Daavsan/Exjobb/Billder/Värmekamera/FLIR0883.jpg

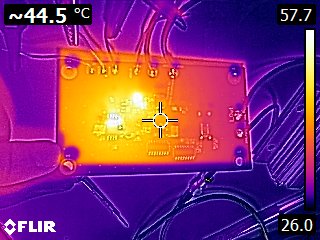
Billder/Värmekamera/FLIR0883.jpg
