Daavsan/Exjobb/Billder/Värmekamera/FLIR0885.jpg

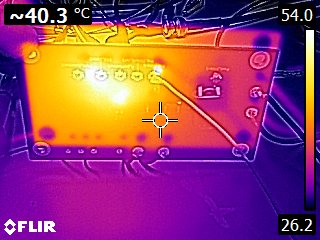
Billder/Värmekamera/FLIR0885.jpg
