Daavsan/Exjobb/Obsidian/Exjobb/Daglig rapport/Daglig rapport.md

# V38
## 24-09-17
Läst artiklar om berring currents, 20MHz, 20A. [1](https://blog.est-aegis.com/three-types-of-bearing-current) [2](file:///C:/Users/A1201-admin/Downloads/Circulating_bearing_currents_quantification-1.pdf) [3](https://www.est-aegis.com/bearing-protection/shaft-voltage-and-bearing-currents/)
Läst om förstärkare och strömgeneration. [Technology Overview](obsidian://open?vault=Exjobb&file=Ultra-High-Bandwidth_Power_Amplifiers_A_Technology_Overview_and_Future_Prospects.pdf)  ej läst denna än [bang bang ](https://ieeexplore.ieee.org/document/1297944)

Möte med jonny och johan.
* Mål är relativt flytande, jag har stor kontrol
* FPGA kan ge olika out, ex pwm eller digital bitar
* 20A vid extremfall <0.5 $\Omega$  -> 100w max i pulser
* 1-5w continuerligt
* bang buck
* åtminståne skri om digtal DA alternativ
* pressision tpy 5% men viktigare att möta med hög pressition

## 24-09-17
asd
