Daavsan/Exjobb/Obsidian/Exjobb/High pressision mesurments.md

[Sensor Overview](https://ieeexplore.ieee.org/abstract/document/1257710) 
* Shunts: 
	* cheap  
	* DC and AC
	* [equations](https://incompliancemag.com/difference-amplifier-common-mode-and-differential-mode-voltages/) 
* Current transformer
	* Capable of tens of MHz
	* Driving circuit are normally not
	* up to 5KA, wiht 20 ns rise time
	*
