Daavsan/Exjobb/Obsidian/Exjobb/PWM Generation.md

[inverter based PWM](https://www.robotroom.com/PWM.html)

Can generate pwm with diode caoacitora nd varableresistor, where r determens the duty cycle

555 Timmer commonly used, but >[[Amplifers#^3f6317||60-200MHz]] is to high (555 max is a few hundred KHz)

Three stage opamp and comparator [PWM generator](https://www.ti.com/lit/an/sboa212a/sboa212a.pdf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) design

Simple [resistor-diode-capacitor-inveter](https://www.robotroom.com/PWM.html) design, obs i couldn't simulate

![[Pasted image 20240923124735.png]]

This [paper](https://ieeexplore.ieee.org/abstract/document/4562735) for fast current mode tirangular wae generator
