Daavsan/Exjobb/Obsidian/Exjobb/Berring Currents.md

* Frequency [up to 20MHz](https://webfiles.portal.chalmers.se/et/MSc/Marinov&RahmanMSc.pdf)
* larger power motor-> higher frequency. 
* Energy has to reach threshold to make arc.
* [up to 20 ampere](https://blog.est-aegis.com/three-types-of-bearing-current) 
* [maybe 0.5 ohm at max](Johan borg) -> ca 100 w peak output power
