Daavsan/Exjobb/Obsidian/Exjobb/Circuit PID.md

[Analog PID](https://link.springer.com/article/10.1007/s00034-020-01540-5) Consept for pull pid

Alt parralell P I D
P: Just gain idk
I: [integrator](https://en.wikipedia.org/wiki/Op_amp_integrator) 
D: [Diffrentiator](https://en.wikipedia.org/wiki/Differentiator)

[Selfe tune analaog pid](https://ieeexplore.ieee.org/abstract/document/1638134)

[PID IN buck boost](https://link.springer.com/article/10.1186/s43067-020-00015-6)

PID in loop to control current

####  Pros
* can control overshoot/Undershoot
* System (except load) Well know -> can tune
* Analog and digital implementation possible.
* I get to apply some control theory
#### Cons
* Reactive load may make tuning hard
* More complex system 

[Self tuning pid](https://ieeexplore.ieee.org/abstract/document/1638134) obs needs microcontroller
[Pid Design](https://www.mdpi.com/1424-8220/24/10/3125)
[pid design, easy to choose poles](https://ieeexplore.ieee.org/abstract/document/9331798)
[Hih input low output inpedance, 3 passive to tune](https://link.springer.com/article/10.1007/s00034-020-01540-5) Kp has min value :[
