Daavsan/Exjobb/Obsidian/Exjobb/Current generator deign.md

## Amplifiers
In this paper[Technology overview](https://ieeexplore.ieee.org/stamp/stamp.jsp?tp=&arnumber=9766331) 

Ide, buck converter, där pwm duty cule styrs av en controller. Alltså FPGA ger (börsingnal-feedback) --> styr cycle på buck. Efter low pass filter mäts ström = feedback 

In [[Ultra-High-Bandwidth_Power_Amplifiers_A_Technology_Overview_and_Future_Prospects.pdf#page=7&selection=0,9,35,34|Ultra-High-Bandwidth_Power_Amplifiers_A_Technology_Overview_and_Future_Prospects, page 7]]
Hyprid (digital and analog) is combined ex, in parralell, with a main supply and a "fine tuning" supply

## Read plan

* [[Berring Currents]] Done
* [[Amplifers]]- ongoing
* [[Circuit PID]]- ongoing
* [[ADC and DAC]] -NOT STARTED
* [[PWM Generation]] -Ongoing
* [[High pressision mesurments]]- NOT started

### Switch test 1
[[Components]]

switching mosfet  and gatedriver test [[switching mosfet  and gatedriver test]]  asd
