Daavsan/Exjobb/Obsidian/Exjobb/Links.md

# Gate driver
[LMG1020-5v 7A 50Mhz](https://www.ti.com/lit/ds/symlink/lmg1020.pdf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)
[LMG1210-200v 3A 50Mhz](https://www.ti.com/lit/ds/symlink/lmg1210.pdf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)
[LMG1025-Q1 60Mhz](https://www.ti.com/lit/ds/symlink/lmg1025-q1.pdf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)

# Mosfets

### RF
[AFT05NP075NR1 136-520 Mhz](https://www.mouser.se/ProductDetail/NXP-Semiconductors/AFT05MP075NR1?qs=RnZx02BLotIGApUaCX%252B4pw%3D%3D) 
[MRF101AN 110W 8A](https://www.mouser.se/datasheet/2/302/MRF101AN-1510799.pdf)

### Non-RF

[mouser](https://www.mouser.se/c/semiconductors/discrete-semiconductors/transistors/rf-transistors/rf-mosfet-transistors/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)
[CSD19538q2](https://www.ti.com/lit/ds/symlink/csd19538q2.pdf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)
[CSD17579Q3A](https://www.ti.com/lit/ds/symlink/csd17579q3a.pdf?ts=1727669525473)

#### Boot strap diode
[100p trr, 70V BAS7002VH6327XTSA1](https://www.digikey.se/en/products/detail/infineon-technologies/BAS7002VH6327XTSA1/5959843)
