Daavsan/Exjobb/Obsidian/Exjobb/Mosfet.md

[Power mosfets gate charge](https://www.vishay.com/docs/73217/an608a.pdf)
