Daavsan/Exjobb/Billder/BearingCurrents.png

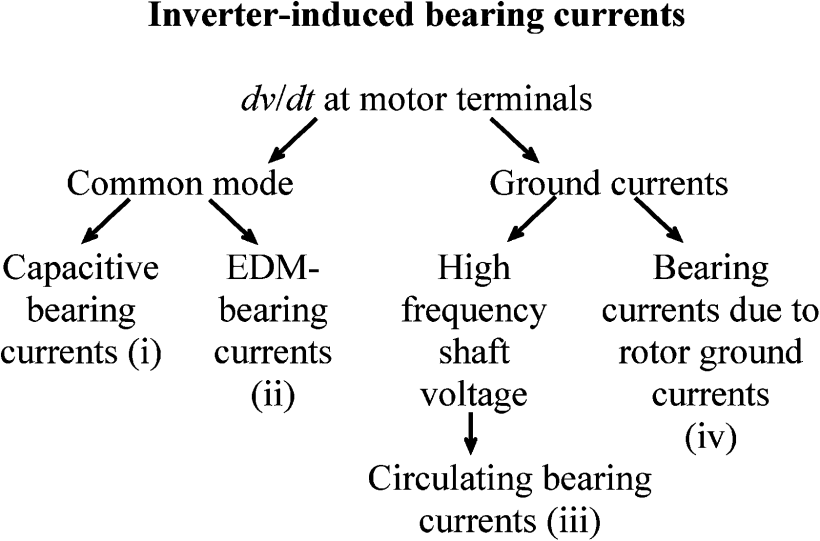
Billder/BearingCurrents.png
