Daavsan/Exjobb/Billder/Prot2/Controller.png

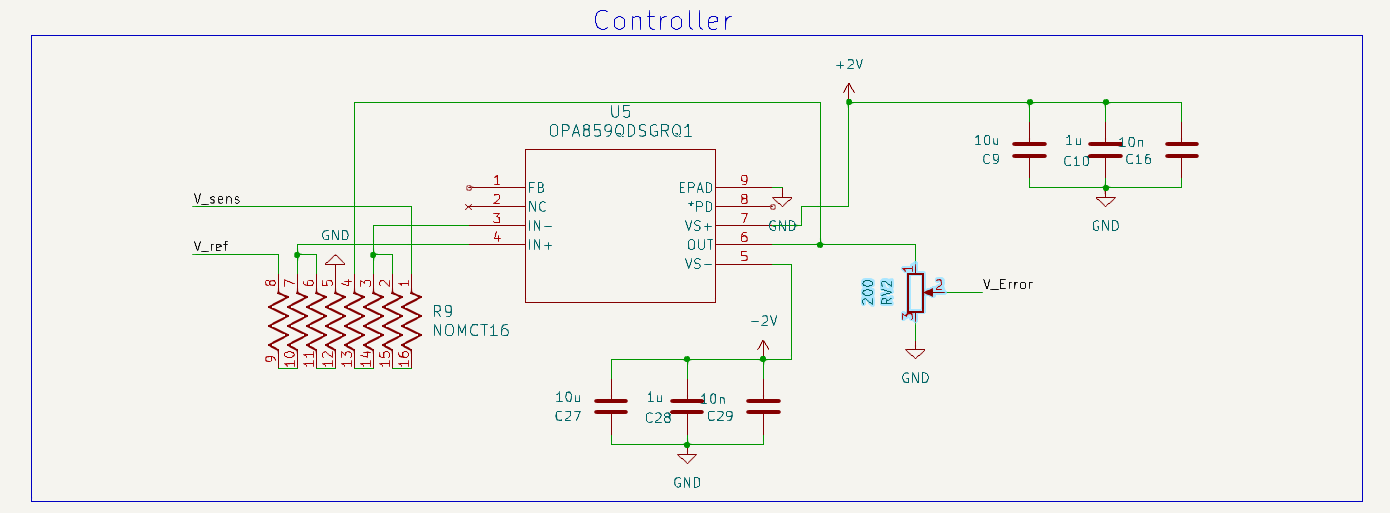
Billder/Prot2/Controller.png
