Daavsan/Exjobb/Billder/Prot2/Filter And Sensor.png

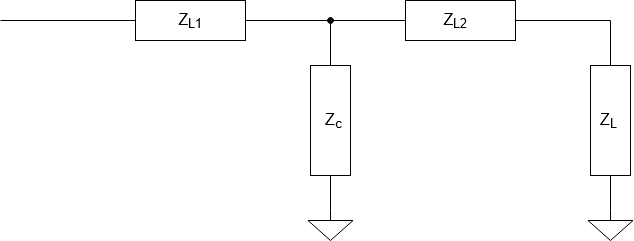
Billder/Prot2/Filter And Sensor.png
