Daavsan/Exjobb/Billder/Prot2/Filter.png

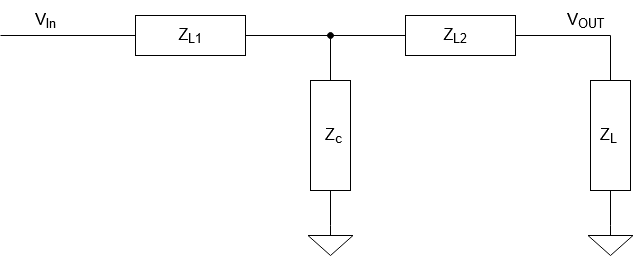
Billder/Prot2/Filter.png
