Daavsan/Exjobb/Billder/Prot2/Layout.png

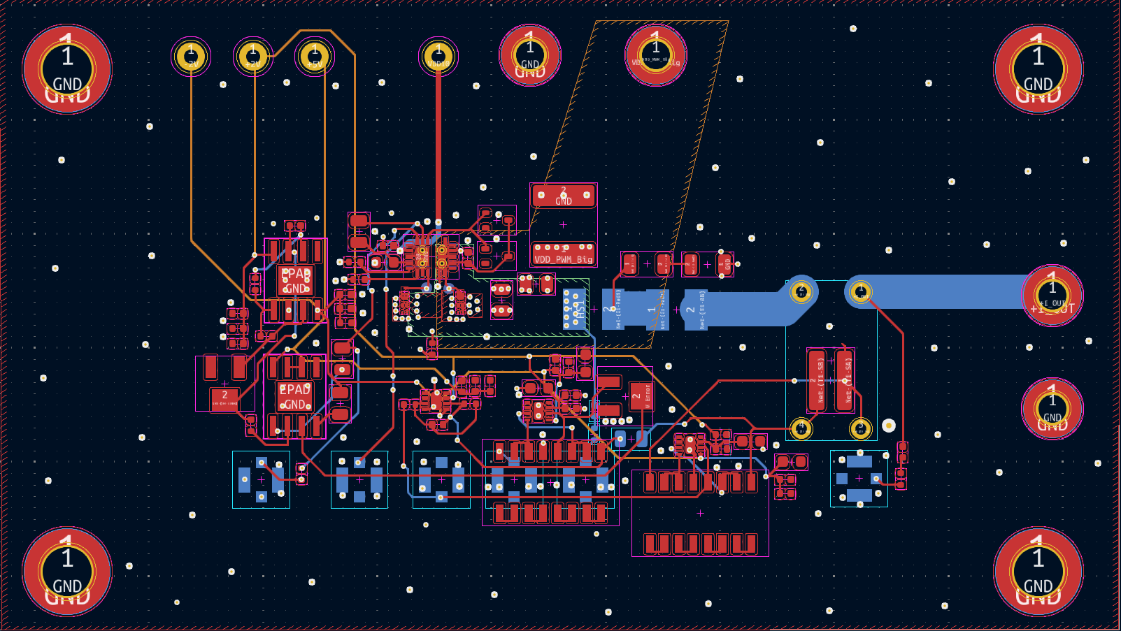
Billder/Prot2/Layout.png
