Daavsan/Exjobb/Billder/Prot2/PWM Generator.png

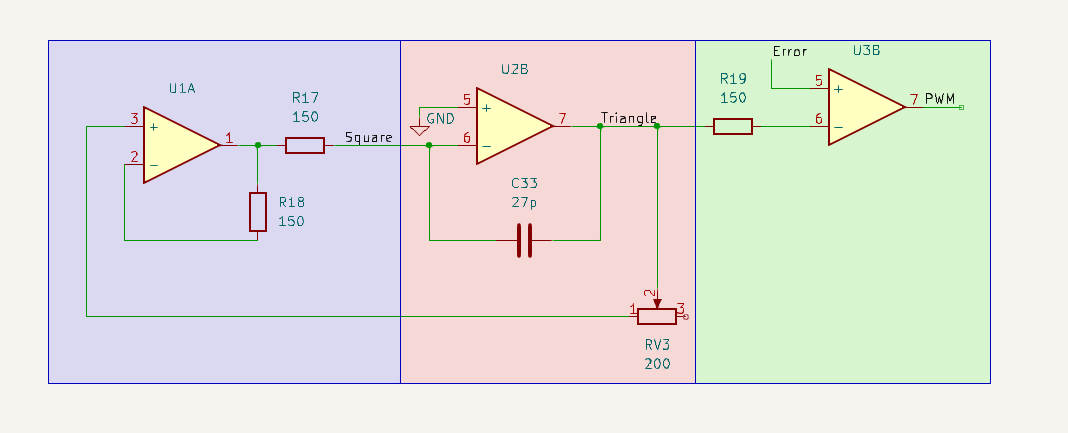
Billder/Prot2/PWM Generator.png
