Daavsan/Exjobb/Billder/Prot2/PWM Generatpr Circut.png

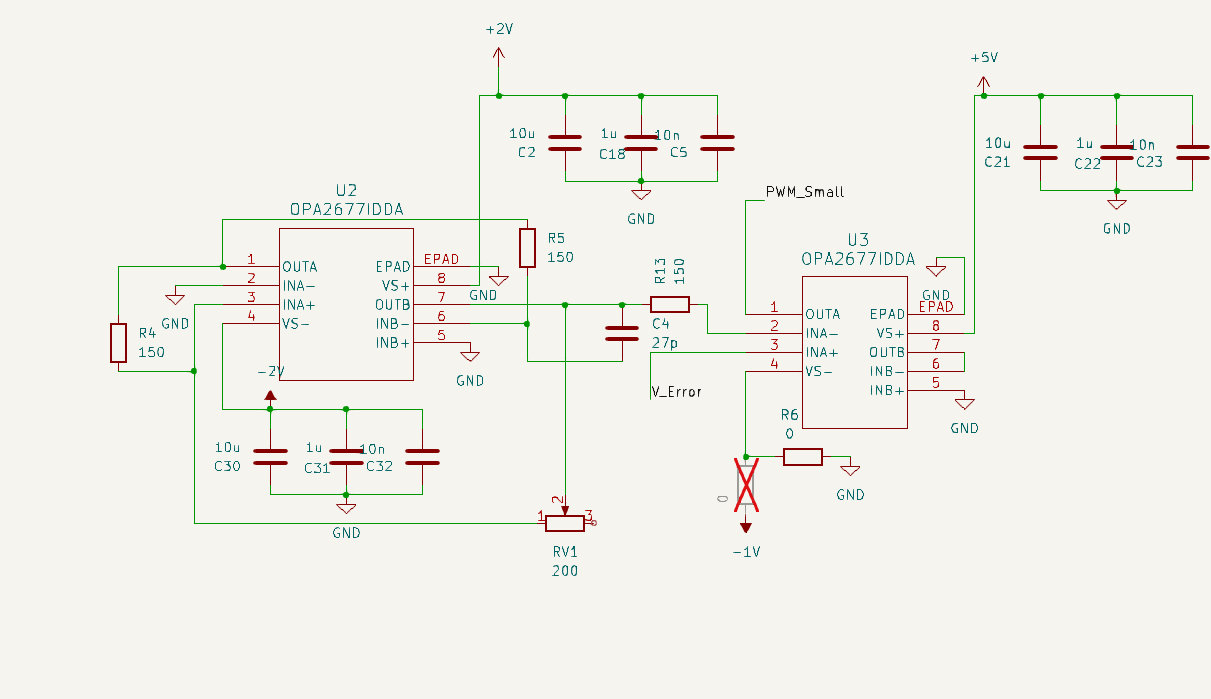
Billder/Prot2/PWM Generatpr Circut.png
