Daavsan/Exjobb/Billder/Prototype1/GateDriverOutput.png

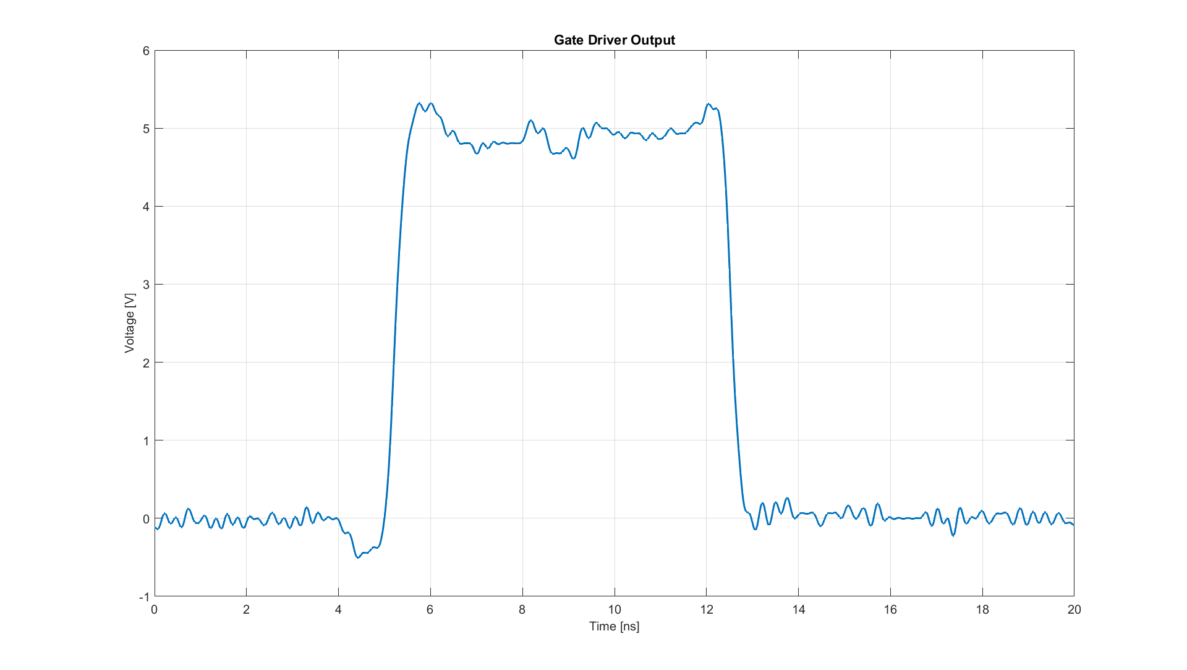
Billder/Prototype1/GateDriverOutput.png
