Daavsan/Exjobb/Billder/Värmekamera/FLIR0881.jpg

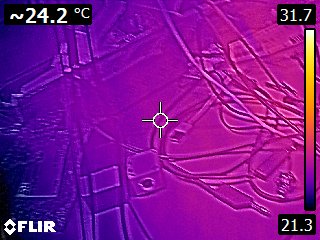
Billder/Värmekamera/FLIR0881.jpg
