Daavsan/Exjobb/Billder/Värmekamera/FLIR0882.jpg

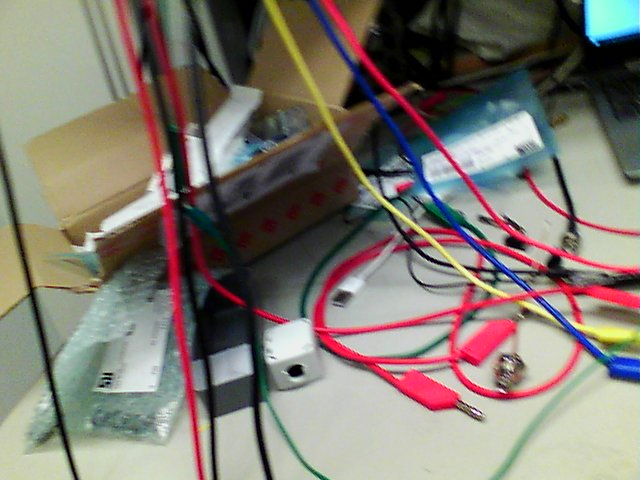
Billder/Värmekamera/FLIR0882.jpg
