Daavsan/Exjobb/Billder/Värmekamera/FLIR0884.jpg

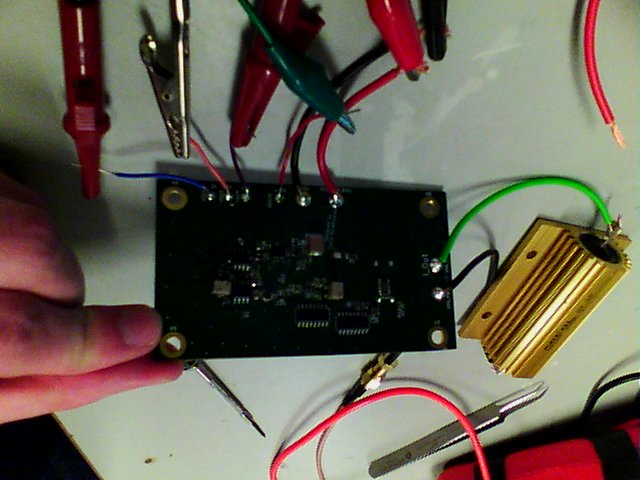
Billder/Värmekamera/FLIR0884.jpg
