Daavsan/Exjobb/Billder/Värmekamera/FLIR0886.jpg

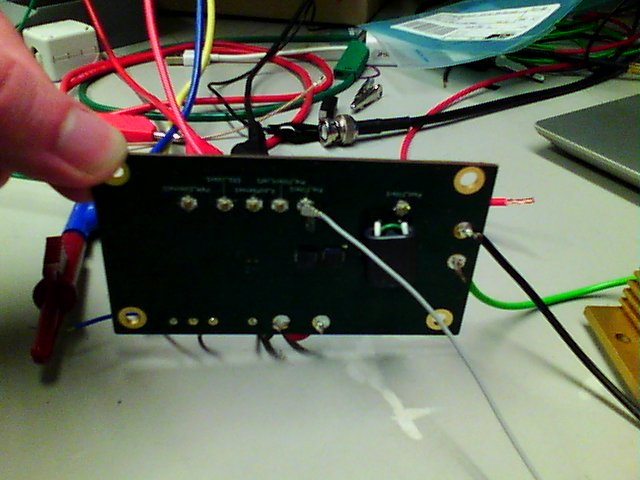
Billder/Värmekamera/FLIR0886.jpg
