Daavsan/Exjobb/Obsidian/Exjobb/Pasted image 20240916152506.png

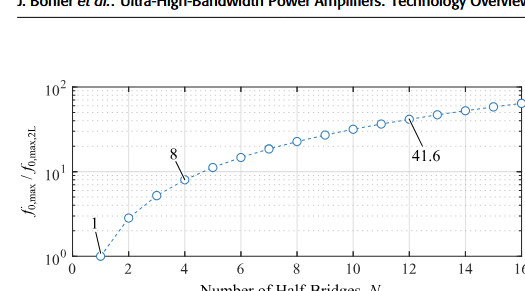
Obsidian/Exjobb/Pasted image 20240916152506.png
