Daavsan/Exjobb/Obsidian/Exjobb/Pasted image 20240923124735.png

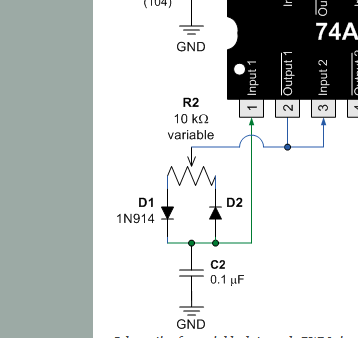
Obsidian/Exjobb/Pasted image 20240923124735.png
