Daavsan/Exjobb/Obsidian/Exjobb/PWM Pulse.png

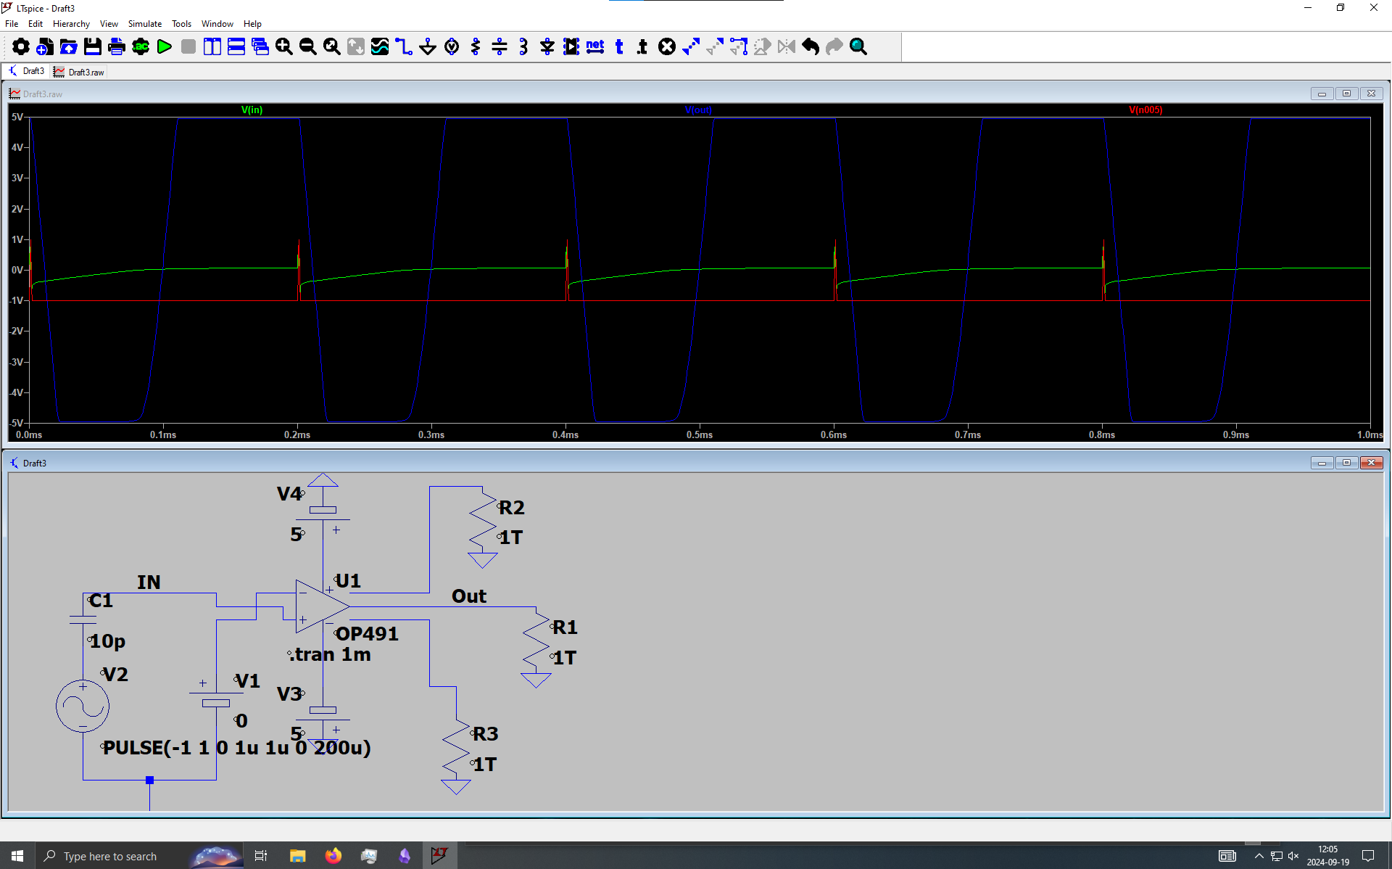
Obsidian/Exjobb/PWM Pulse.png
