Daavsan/Exjobb/Obsidian/Exjobb/SyncronusBuck.png

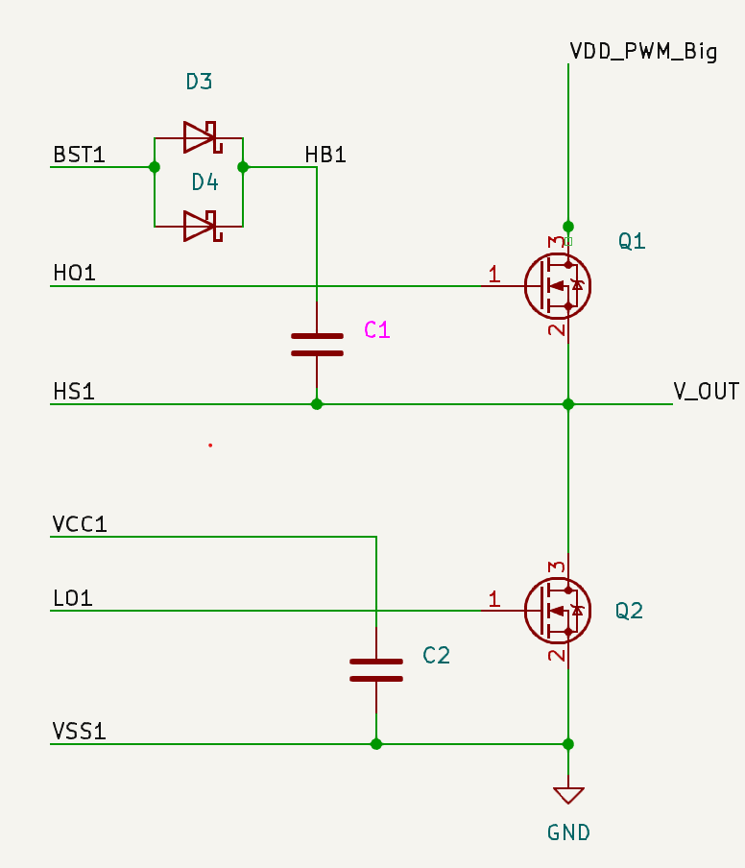
Obsidian/Exjobb/SyncronusBuck.png
