Daavsan/Exjobb/Orcad/FILTER.png

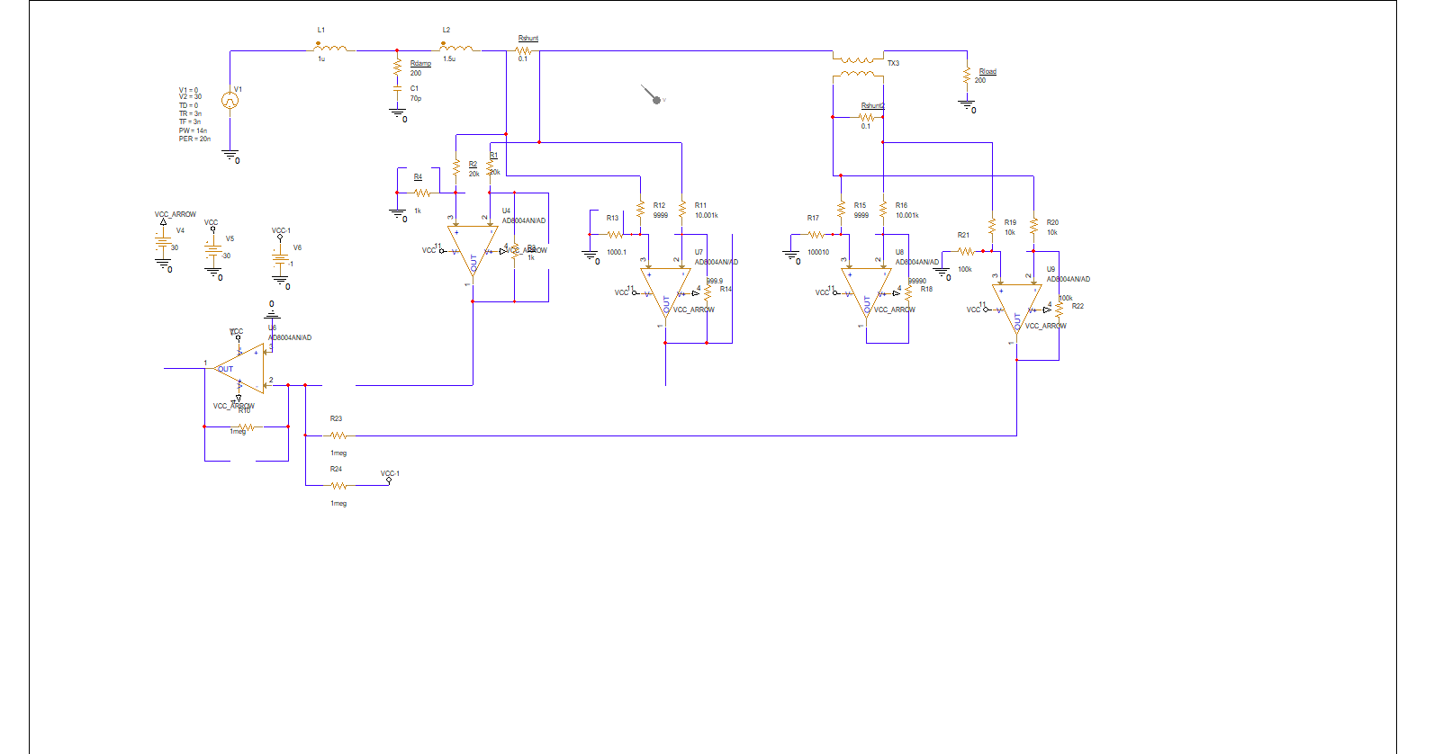
Orcad/FILTER.png
