Daavsan/Exjobb/Orcad/MOSTEST.png

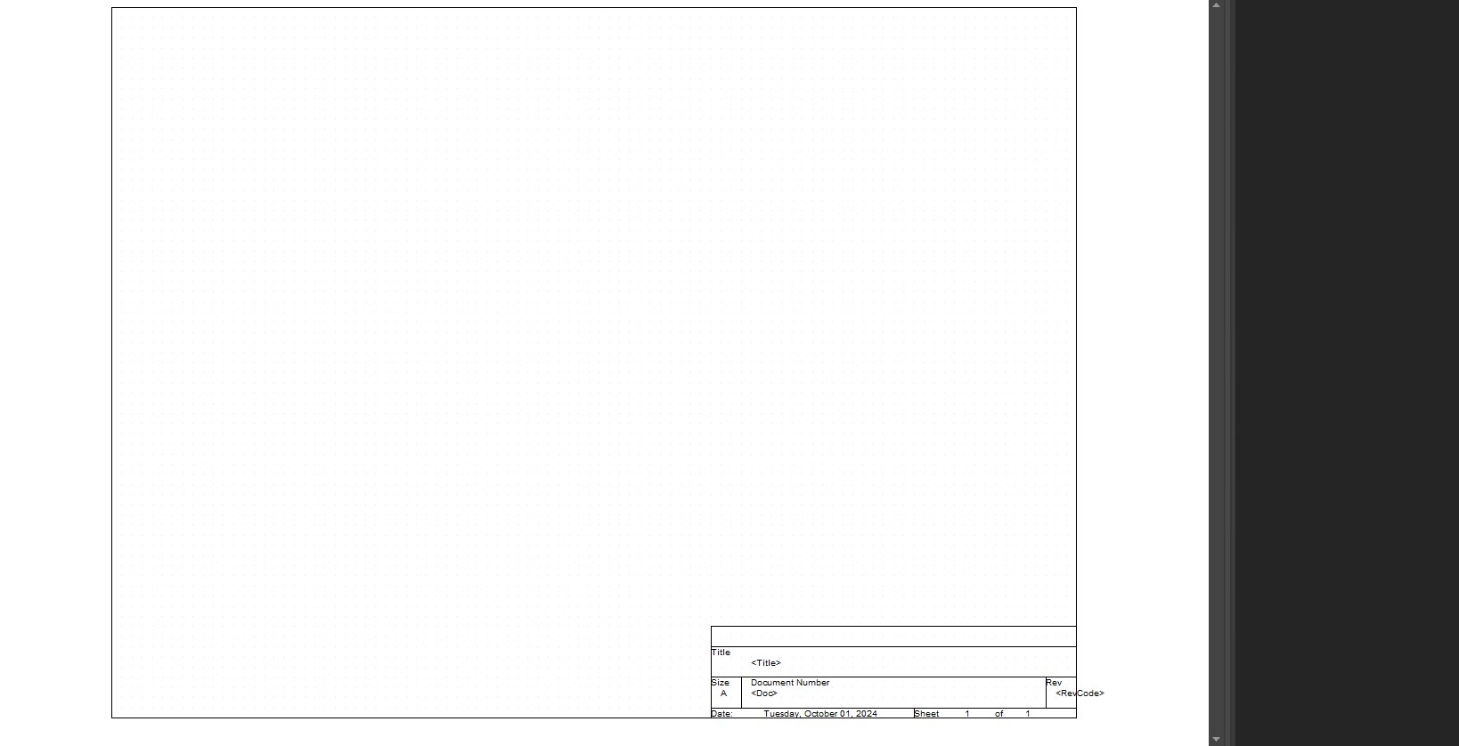
Orcad/MOSTEST.png
