Daavsan/Exjobb/Orcad/MOSTEST_CADENCE.png

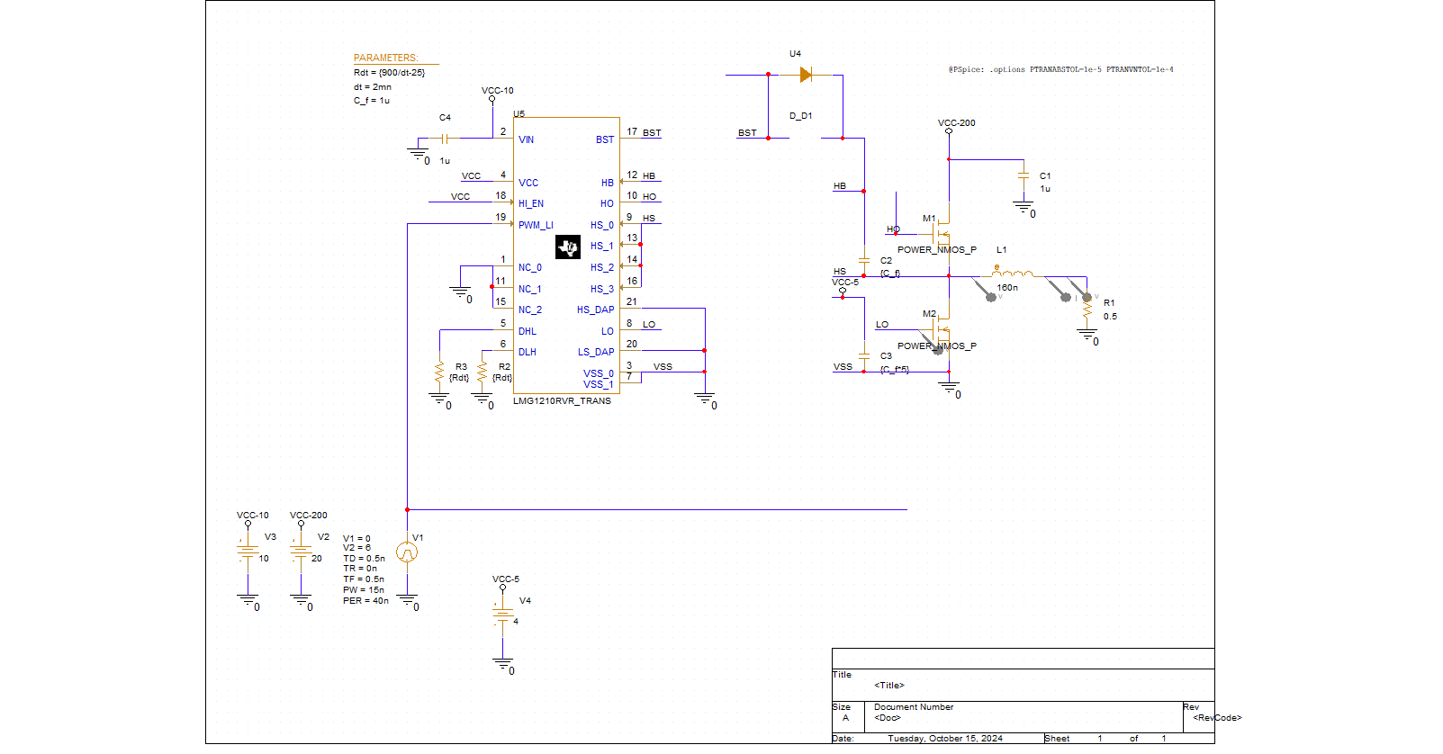
Orcad/MOSTEST_CADENCE.png
