Daavsan/Exjobb/Orcad/SUMMTEST.png

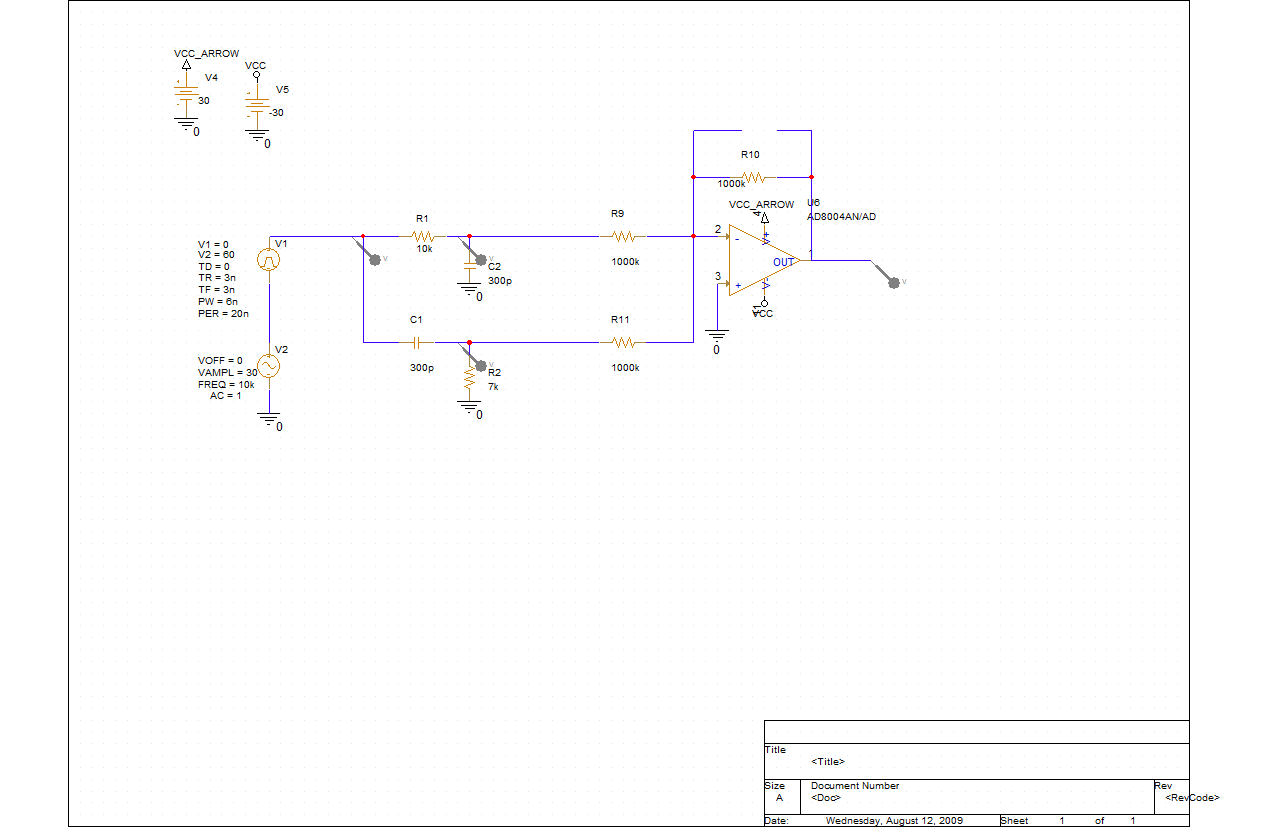
Orcad/SUMMTEST.png
