Daavsan/Exjobb/Temp/20mhz-lo_2024-10-24_1_161655.png

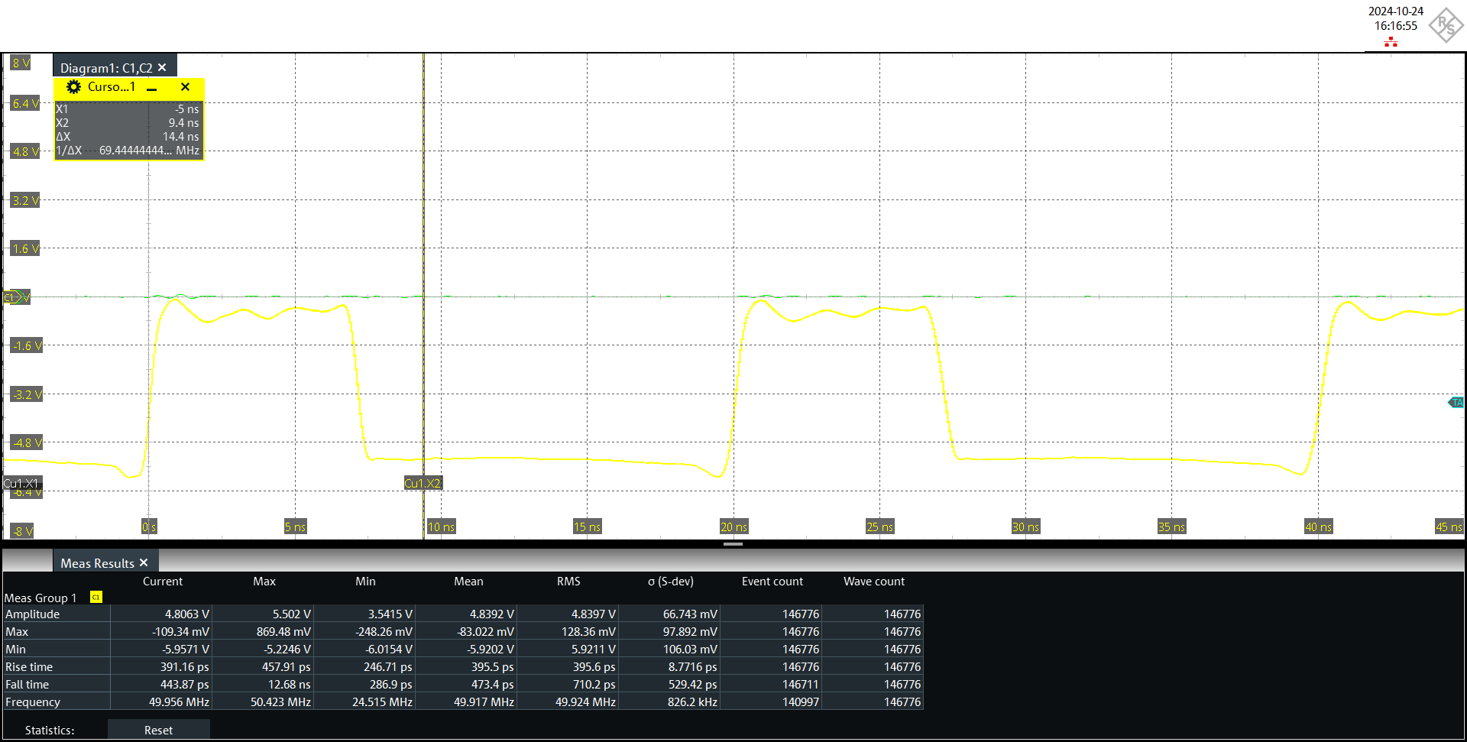
Temp/20mhz-lo_2024-10-24_1_161655.png
