Daavsan/Exjobb/Temp/Screenshot_2024-10-24_0_142127.png

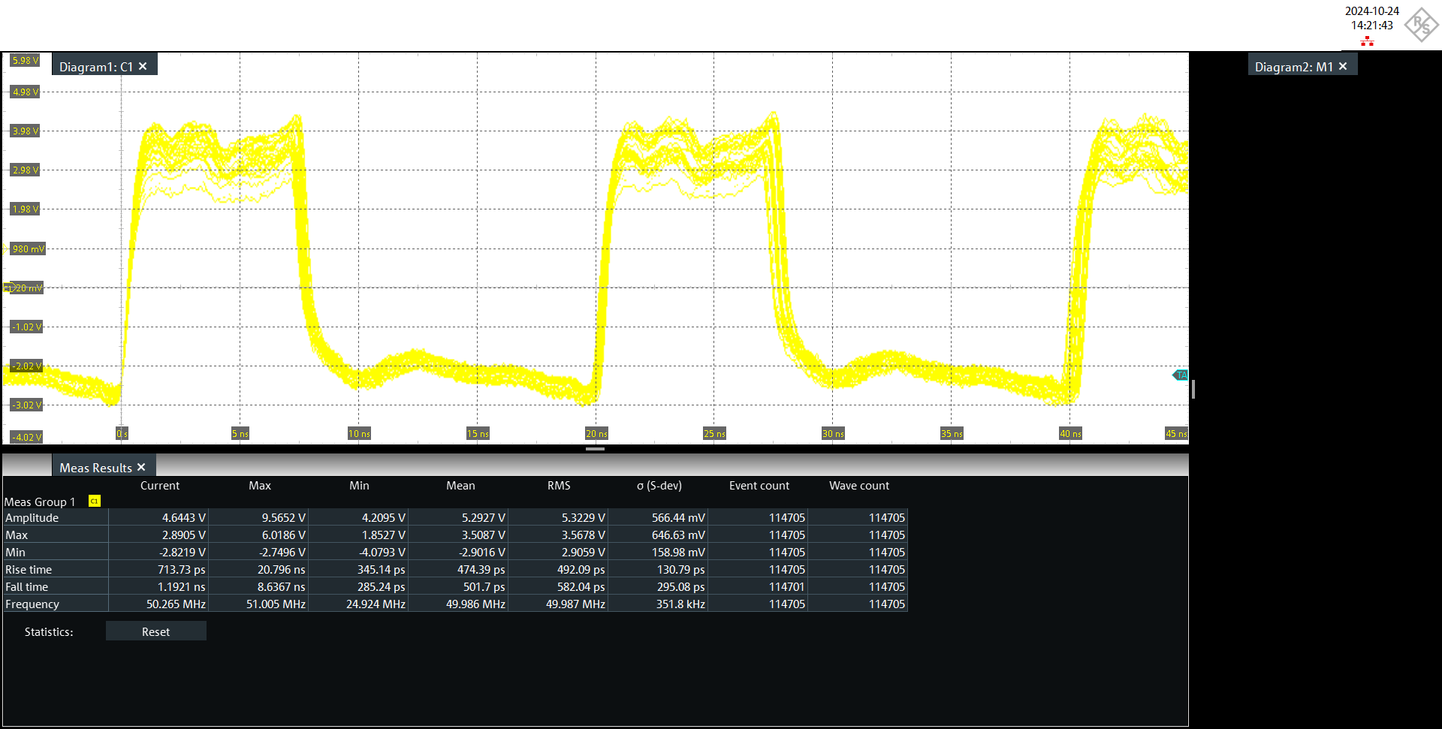
Temp/Screenshot_2024-10-24_0_142127.png
