Daavsan/Exjobb/MosTest_köplista/DigiKey_David.xlsx

Index | Quantity | Part Number | Manufacturer Part Number | Description | Customer Reference | Available | Backorder | Unit Price | Extended Price SEK
1 | 3 | 917-1078-1-ND | EPC8009 | GANFET N-CH 65V 4A DIE |  | 3 | 0 | 39.49 | 118.47
2 | 3 | 296-LMG1210RVRRCT-ND | LMG1210RVRR | IC GATE DRVR GAN MOSFET |  | 3 | 0 | 47.06 | 141.18
