Daavsan/Exjobb/MosTest/Mätningar/100nsGATES.csv

CPgReferenceCurveAttributes:SourceType:Source:
Resolution:1e-10:
RecordLength:2000:
HWRecordLength:2000:
TriggerOffset:0:
RescaleCenterTime:0:
DecimationMode:Sample:
TraceArithmetics:Off:
TraceType:Normal:
BaseUnit:V:
BaseUnitRelative:Off:
Impedance:50:
XStart:-3.17e-08:
XStop:1.683e-07:
SignalRecordLength:2000:
HardwareXStart:-3.17e-08:
HardwareXStop:1.683e-07:
SignalHardwareRecordLength:2000:
AdjustedResolutionBW:0:
NoiseBandwidth:0:
InterleavedTraceCount:1:
ValueType:Completely finite and defined:
NofQuantisationLevels:253:
DecimationFactor:1:
TOADone:Off:
ISO_TRG:148:
SC_POST:-1584978568:
SC_TRG:-1584979611:
SignalResolution:1e-10:
LeadingSettlingSamples:0:
TimeScale:2e-08:
ReferencePoint:50:
RescaleCenterPoint:50:
VerticalPosition:0:
VerticalScale:2:
VerticalOffset:0:
BaseYStart:-10:
BaseYStop:10:
ViewUnit:V:
ViewUnitRelative:Off:
ViewReferenceLevel:0:
UseInterSampleTriggerOffset:Auto:
Source:C2W1:
NumericFormat:Decimal:
EnhancementMode:Real time:
InterpolationMode:sin(x)/x:
CenterFreq:0:
FreqSpan:1000:
ResolutionBW:1:
FrequencyStart:0:
FrequencyStop:0:
WindowType:Rectangular:
GateRBWCoupling:Record length controlled:
HorizontalDivisionCount:10:
VerticalDivisionCount:10:
MultiChannelExport:On:
MultiChannelVerticalOffset:4:0:0:0:0.6:
MultiChannelVerticalPosition:4:0:0:0:0:
MultiChannelVerticalScale:4:0:2:0:2:
MultiChannelBaseYStart:4:0:-10:0:-9.4:
MultiChannelBaseYStop:4:0:10:0:10.6:
MultiChannelExportState:4:Off:On:Off:On:
MultiChannelViewUnit:4::V::V:
MultiChannelInterleavedTraceCount:4:1:1:1:1:
MultiChannelSource:4:None:C2W1:None:C4W1:
FirmwareVersion:5.35.1.0:
MaterialNumber:1802.0001k04:
SerialNumber:111494:
SignalFormat:FLOAT:
Origin:Waveform export:
ByteOrder:LSB first:
NumberOfAcquisitions:1:
TimestampState:Off:
Timestamp:9:54 38,991.190.407 s:
XAxisMode:Linear:
XAxisTDRDomain:time:
tdelay:0:
IncludesCDR:Off:
AdvancedJitterHistogramBins:200:
ReferenceCDRAttributes:
