Daavsan/Exjobb/MosTest/Mätningar/100nsGates3nstdt.csv

CPgReferenceCurveAttributes:SourceType:Source:
Resolution:1e-10:
RecordLength:2000:
HWRecordLength:2000:
TriggerOffset:0:
RescaleCenterTime:0:
DecimationMode:Sample:
TraceArithmetics:Off:
TraceType:Normal:
BaseUnit:V:
BaseUnitRelative:Off:
Impedance:50:
XStart:-1e-07:
XStop:1e-07:
SignalRecordLength:2000:
HardwareXStart:-1e-07:
HardwareXStop:1e-07:
SignalHardwareRecordLength:2000:
AdjustedResolutionBW:0:
NoiseBandwidth:0:
InterleavedTraceCount:1:
ValueType:Completely finite and defined:
NofQuantisationLevels:253:
DecimationFactor:1:
TOADone:Off:
ISO_TRG:379:
SC_POST:-1676449500:
SC_TRG:-1676450560:
SignalResolution:1e-10:
LeadingSettlingSamples:0:
TimeScale:2e-08:
ReferencePoint:50:
RescaleCenterPoint:50:
VerticalPosition:0:
VerticalScale:1.6:
VerticalOffset:0:
BaseYStart:-8:
BaseYStop:8:
ViewUnit:V:
ViewUnitRelative:Off:
ViewReferenceLevel:0:
UseInterSampleTriggerOffset:Auto:
Source:C1W1:
NumericFormat:Decimal:
EnhancementMode:Real time:
InterpolationMode:sin(x)/x:
CenterFreq:0:
FreqSpan:1000:
ResolutionBW:1:
FrequencyStart:0:
FrequencyStop:0:
WindowType:Rectangular:
GateRBWCoupling:Record length controlled:
HorizontalDivisionCount:10:
VerticalDivisionCount:10:
MultiChannelExport:On:
MultiChannelVerticalOffset:4:0:0:0:0:
MultiChannelVerticalPosition:4:0:0:0:0:
MultiChannelVerticalScale:4:1.6:1.6:0:0:
MultiChannelBaseYStart:4:-8:-8:0:0:
MultiChannelBaseYStop:4:8:8:0:0:
MultiChannelExportState:4:On:On:Off:Off:
MultiChannelViewUnit:4:V:V:::
MultiChannelInterleavedTraceCount:4:1:1:1:1:
MultiChannelSource:4:C1W1:C2W1:None:None:
FirmwareVersion:5.35.1.0:
MaterialNumber:1802.0001k04:
SerialNumber:111494:
SignalFormat:FLOAT:
Origin:Waveform export:
ByteOrder:LSB first:
NumberOfAcquisitions:1:
TimestampState:Off:
Timestamp:14:40 3,656.590.104 s:
XAxisMode:Linear:
XAxisTDRDomain:time:
tdelay:0:
IncludesCDR:Off:
AdvancedJitterHistogramBins:200:
ReferenceCDRAttributes:
