Daavsan/Exjobb/Billder/GanFet_test_Layout.png

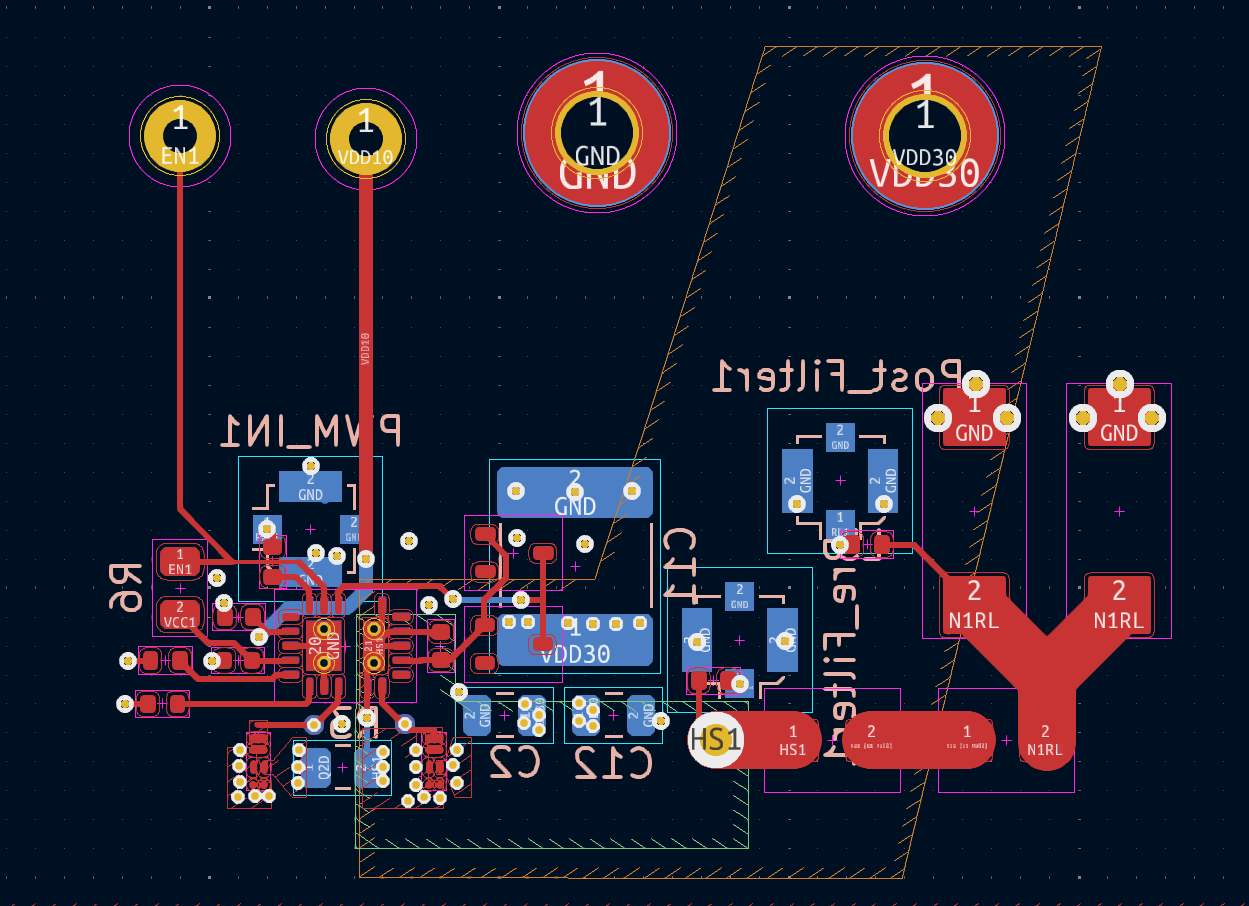
Billder/GanFet_test_Layout.png
