Daavsan/Exjobb/Billder/GanFet_test_sceamatic.png

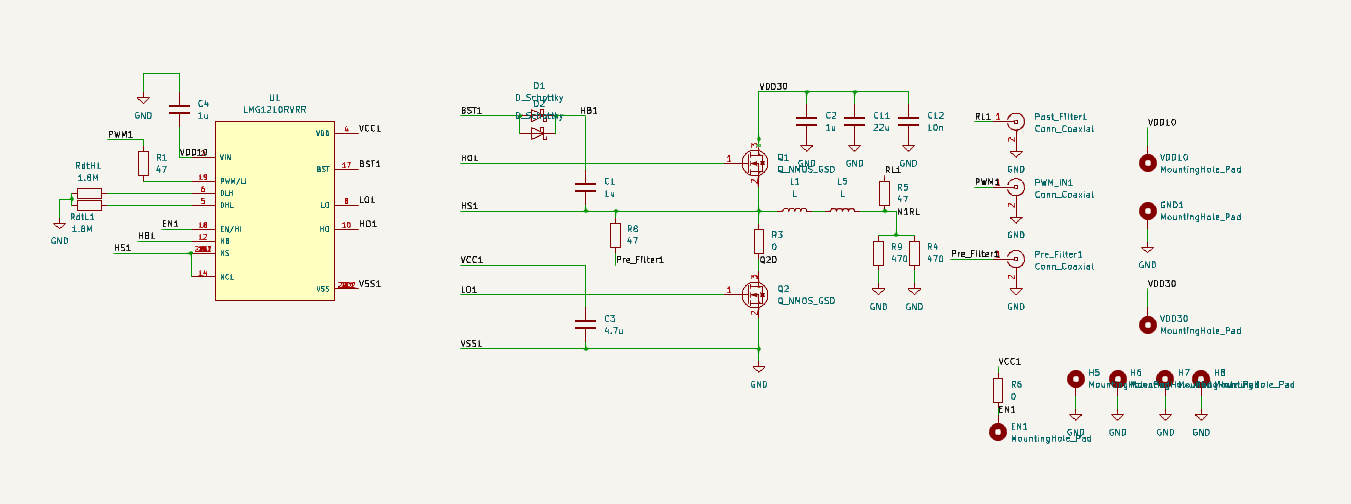
Billder/GanFet_test_sceamatic.png
