Daavsan/Exjobb/Billder/RFFet_test_Layout.png

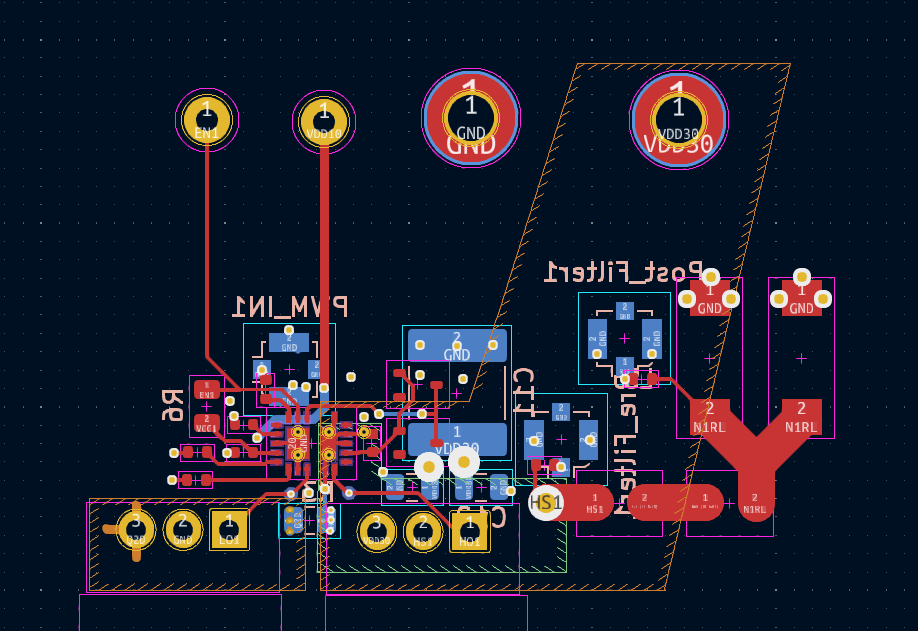
Billder/RFFet_test_Layout.png
