Daavsan/Exjobb/Orcad/FILTER TEST.png

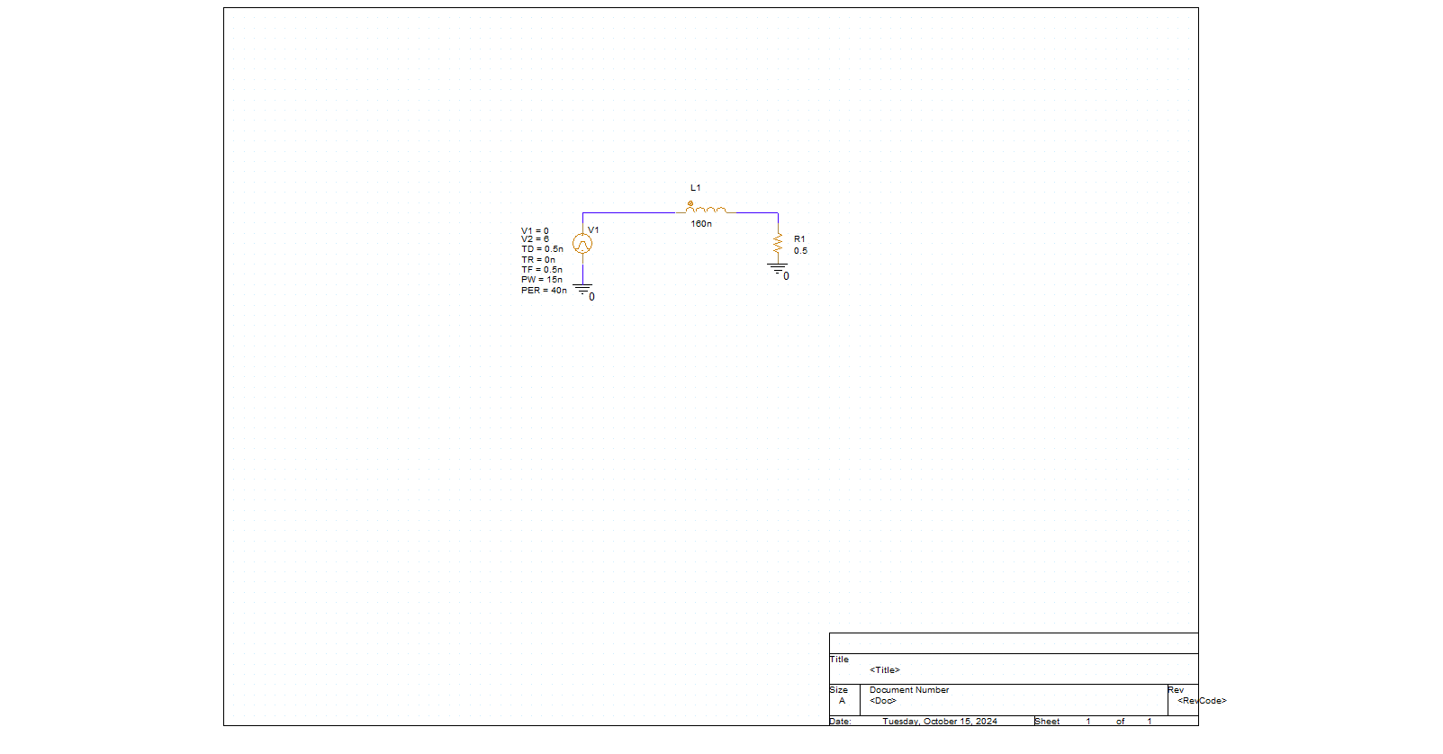
Orcad/FILTER TEST.png
