Daavsan/Exjobb/Orcad/TEST.png

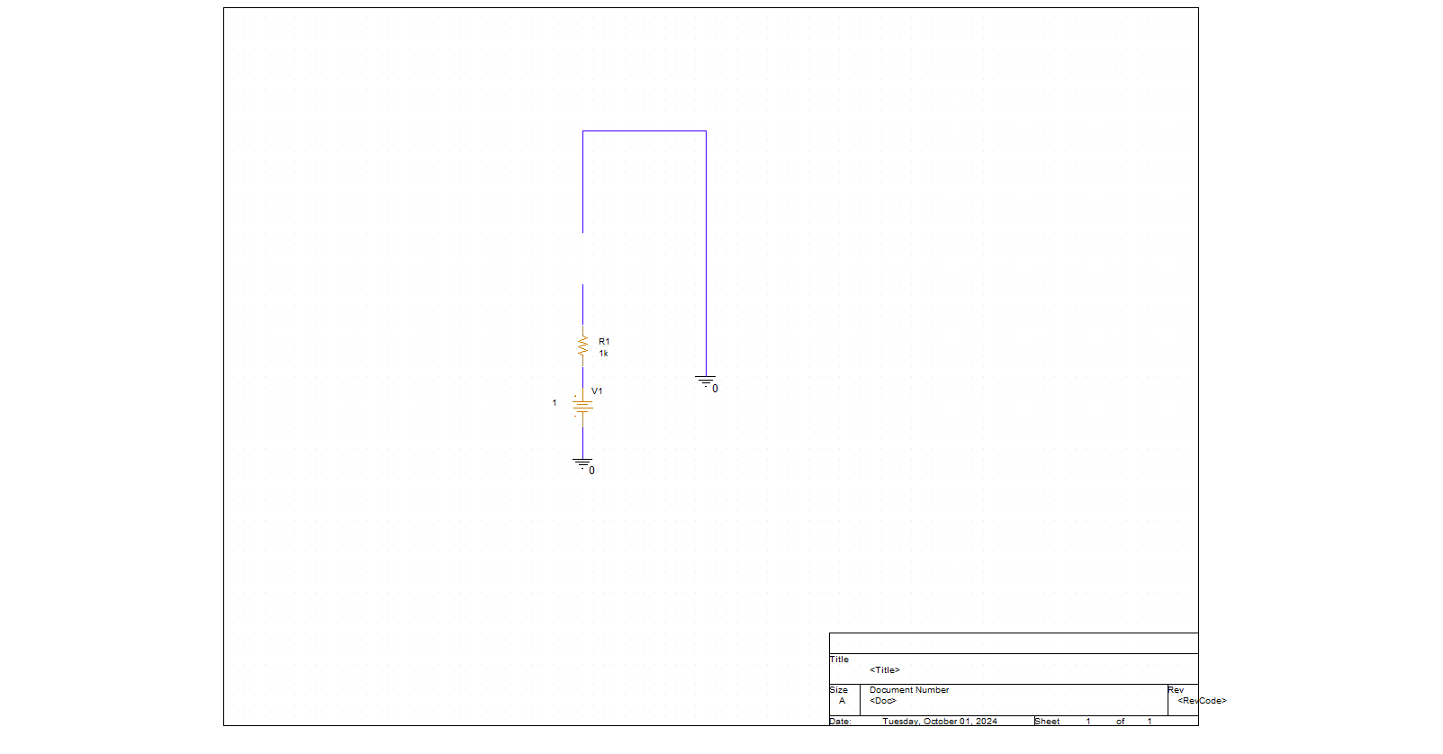
Orcad/TEST.png
