Daavsan/Exjobb/V1Test/filerFft.png

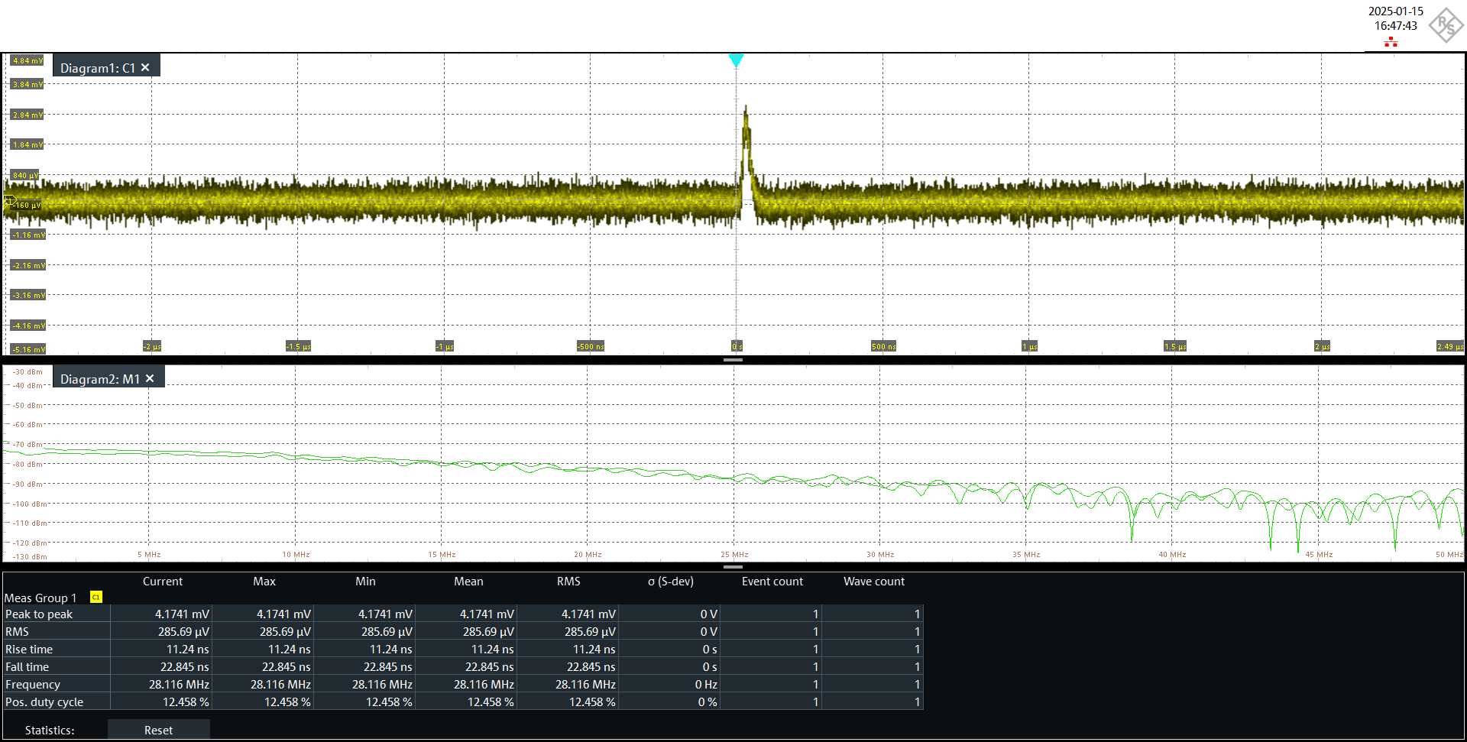
V1Test/filerFft.png
