Daavsan/Exjobb/Billder/faq_MOS_07-1.webp

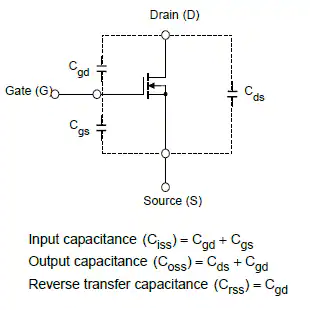
Billder/faq_MOS_07-1.webp
