Daavsan/Exjobb/Billder/Prot2/V1__Assembly.pdf

A

A

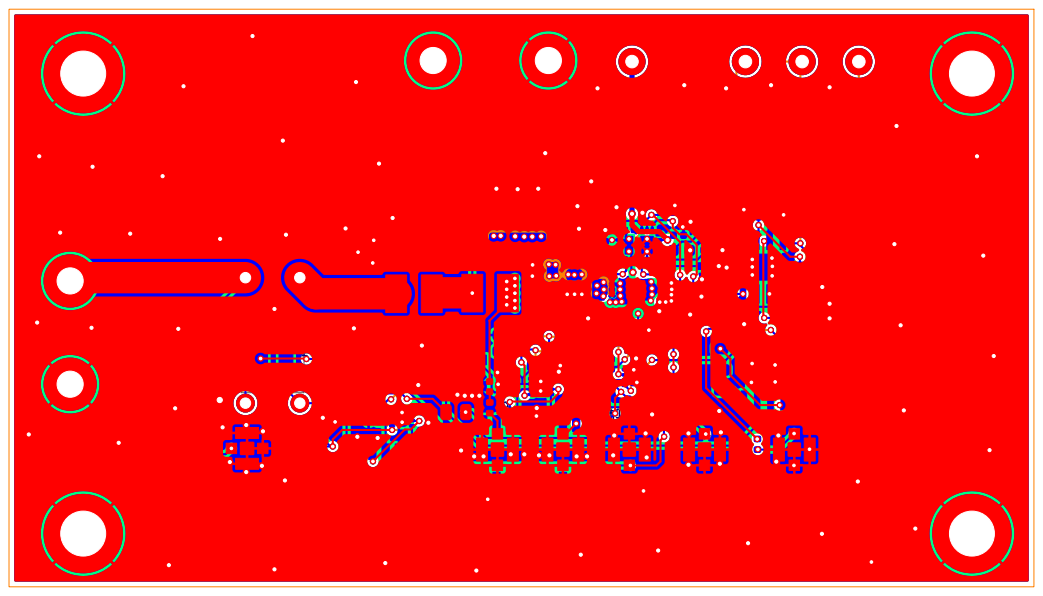
[picture p32: page 1]
V_duffsense1; PWM_External1 R14 L2; L1 T1 Post_Filter1; Pre_FilterV_ref1 C14 R19Pre_Filter1; EN1_coax1 1; D Date: KiCad; E.D.A. 8.0.5 Size: A4; Rev:; Conn_Coaxial Conn_Coaxial; PWM_External1 V_duffsense1 ⁴⁹.9R14 L11u 1.5u L2 Transformer_1P_1S; T1Conn_Coaxial Post_Filter1; Conn_Coaxial Pre_FilterV_ref1 ¹⁰nC14 0; R19 Conn_Coaxial Pre_Filter1; Conn_Coaxial EN1_coax1

Id: 1/1 Title: File: V1.kicad_pcb Sheet:
