Daavsan/Exjobb/KiCad/V1/V1.pdf

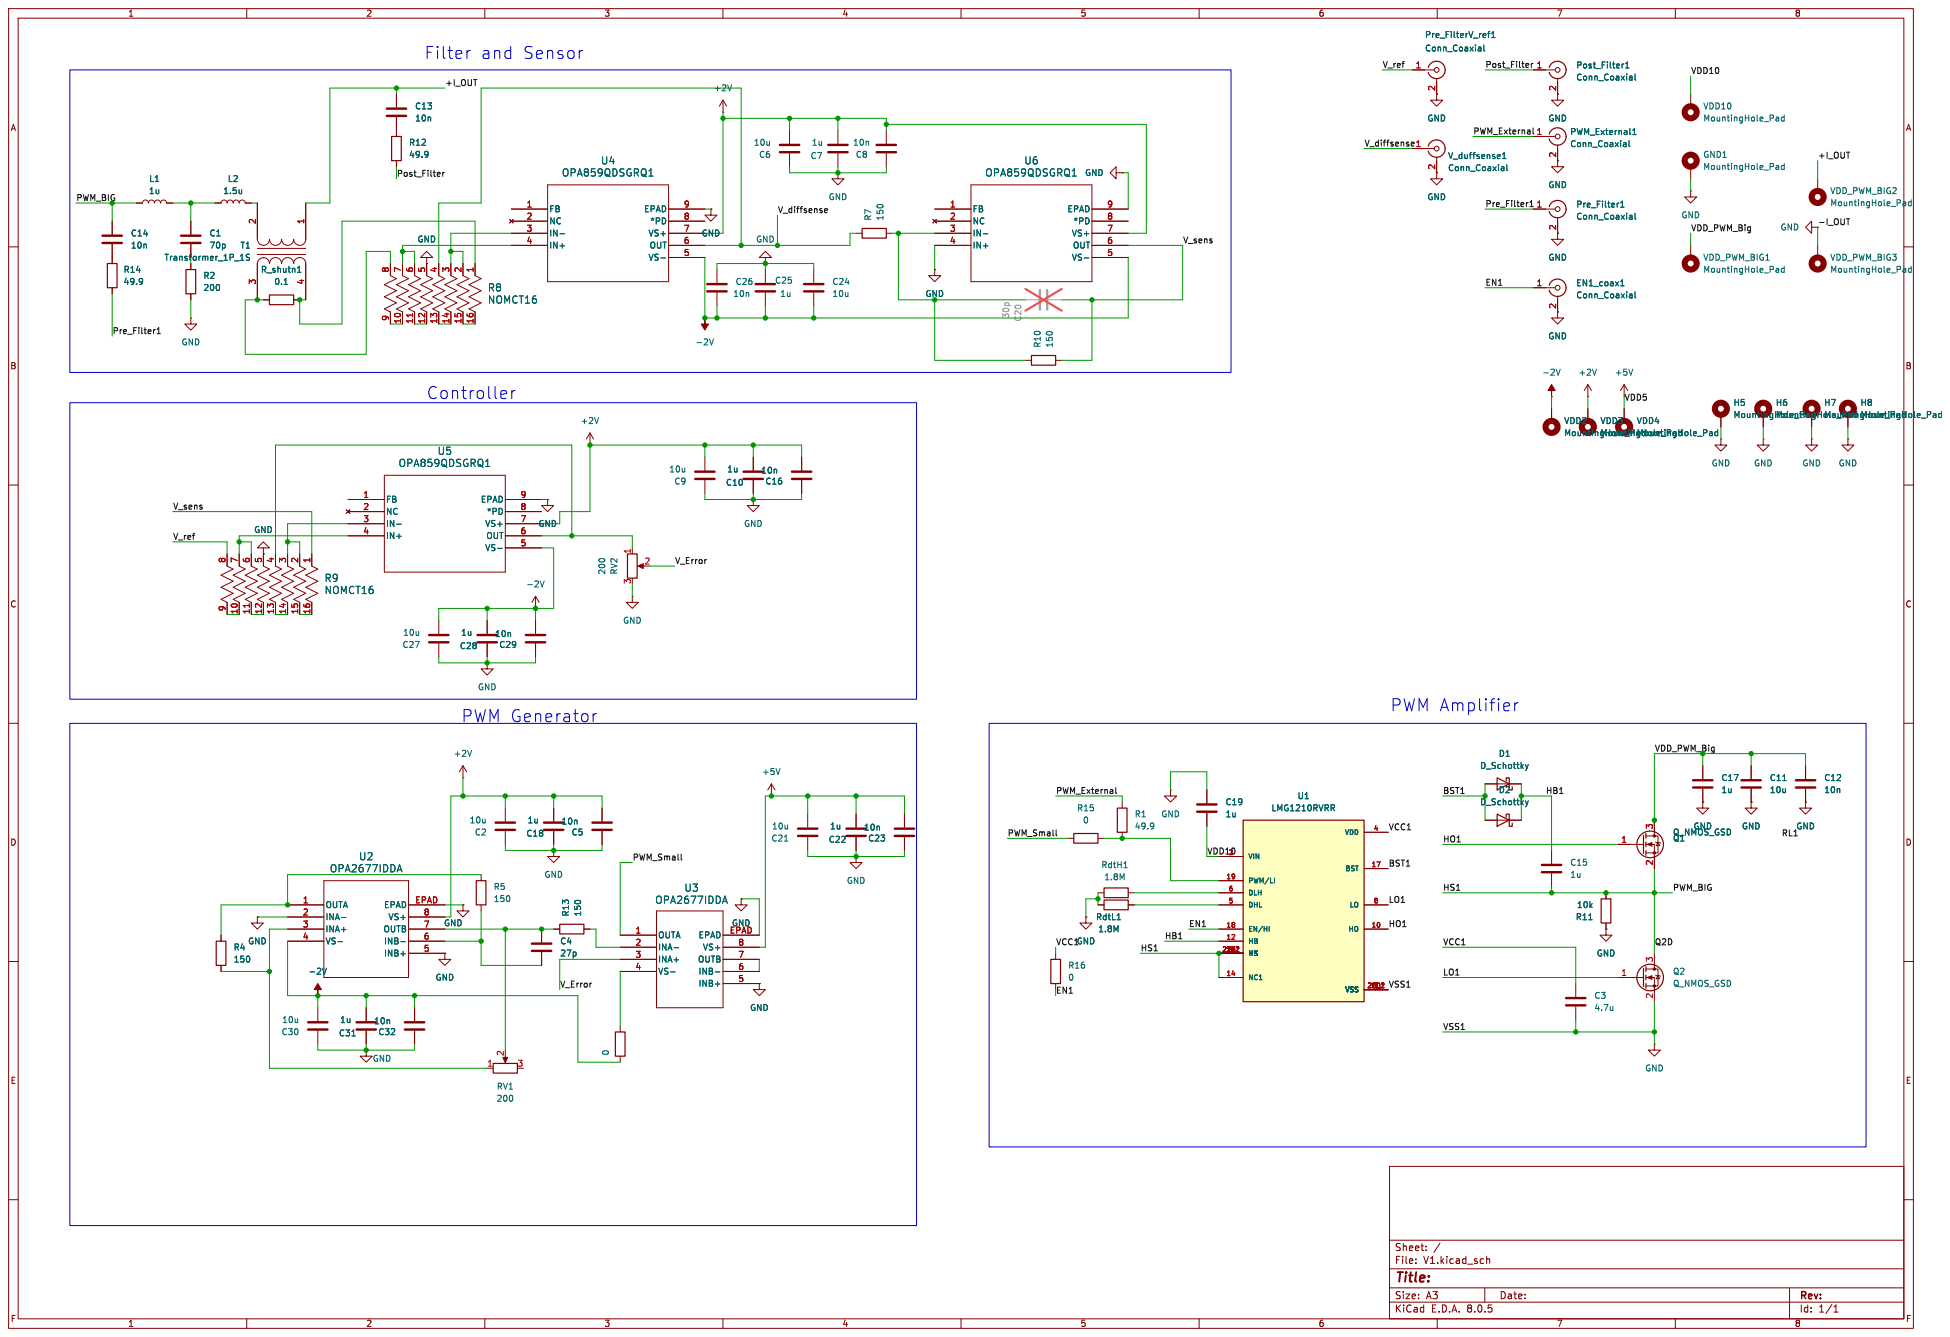
[picture p33: page 1]

Id: 1/1 Title: File: V1.kicad_sch Sheet: / C32
