Daavsan/Exjobb/MosTest_GanFet/Figurer/DeadTime.pdf

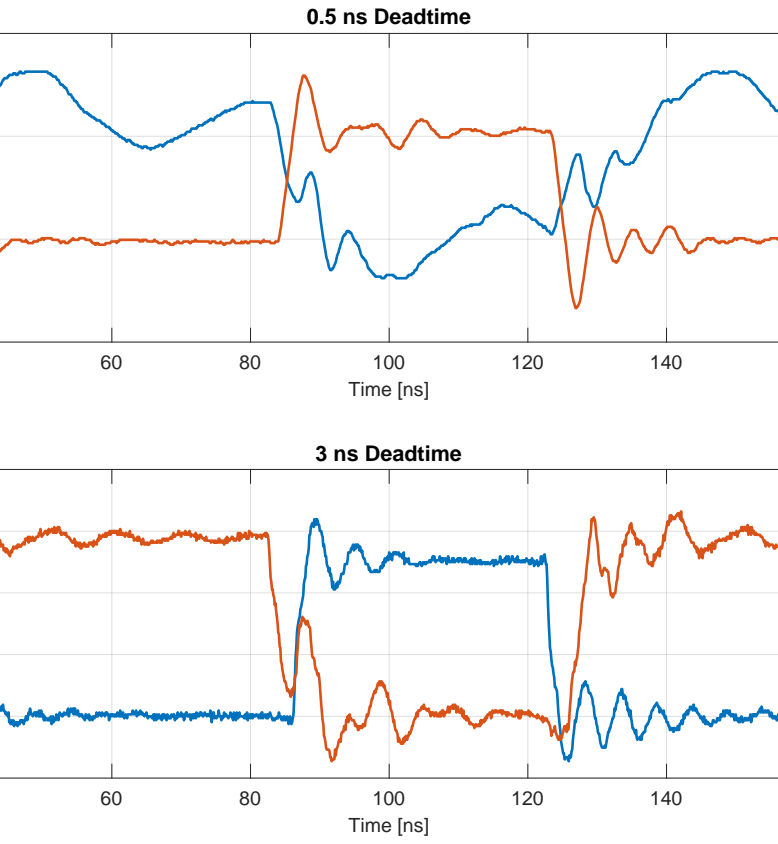
[picture p34: page 1]
Time [ns]; 0.5 ns Deadtime; 3 ns Deadtime
