Daavsan/Exjobb/Billder/Prot2/V1.pdf

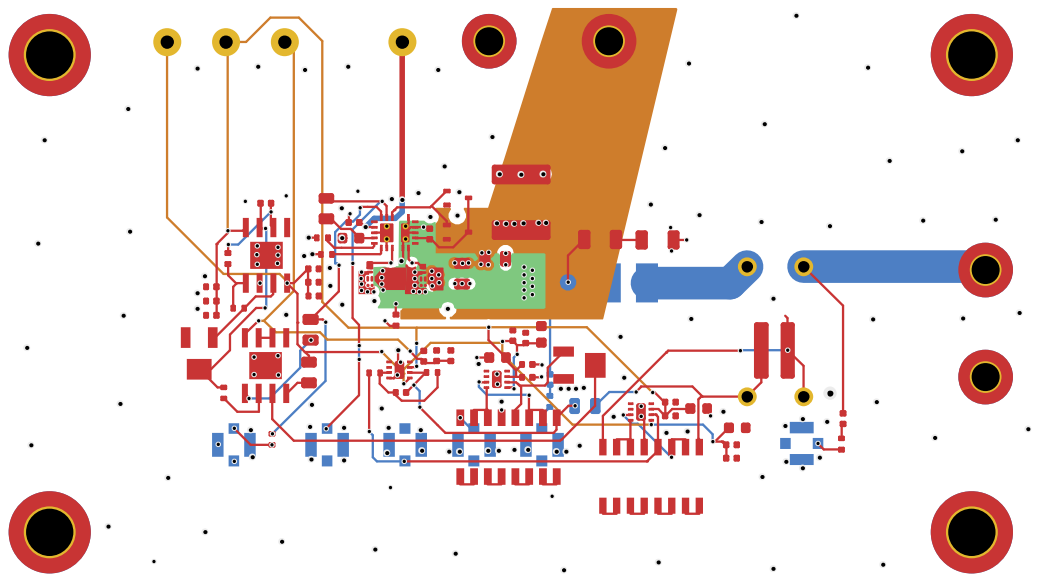
[picture p35: page 1]
