Daavsan/Exjobb/LT_spice_simuleringar/Diode pwm.asc

A1: schmtbuf
A3: schmtbuf
C1: cap; 0.0001µ; V=10 Irms=8.5 Rser=0.0114292 Lser=0 mfg="KEMET" pn="C0402C105K8PAC" type="X5R"
D1: schottky; 1N5818
D2: schottky; 1N5818
R1: res; 70k
R2: res; 30k
Named nets: 0, Out
.tran 0 0.1m 0 0.5n
