Daavsan/Exjobb/(list of files, drawings)

Other design files:
Orcad/ANALOG.OLB
Orcad/BREAKOUT2.OLB
Orcad/BREAKOUT.OLB
Orcad/Filter Test.dsn
Orcad/Filter Test.opj
Orcad/Filter.dsn
Orcad/Filter.opj
Orcad/MOSTEST.DSN
Orcad/MosTest.opj
Orcad/MosTest_cadence.dsn
Orcad/MosTest_cadence.opj
Orcad/PWM Generator 2.dsn
Orcad/PWM Generator 2.opj
Orcad/PWM Generator.dsn
Orcad/PWM Generator.opj
Orcad/SPECIAL2.OLB
Orcad/SPECIAL.OLB
Orcad/SummTest.dsn
Orcad/SummTest.opj
Orcad/Test.dsn
Orcad/Test.opj
