Daavsan/Exjobb/KiCad/V1/V1.kicad_pcb

## KiCad design KiCad/V1/V1.kicad_pcb (2025-01-10)

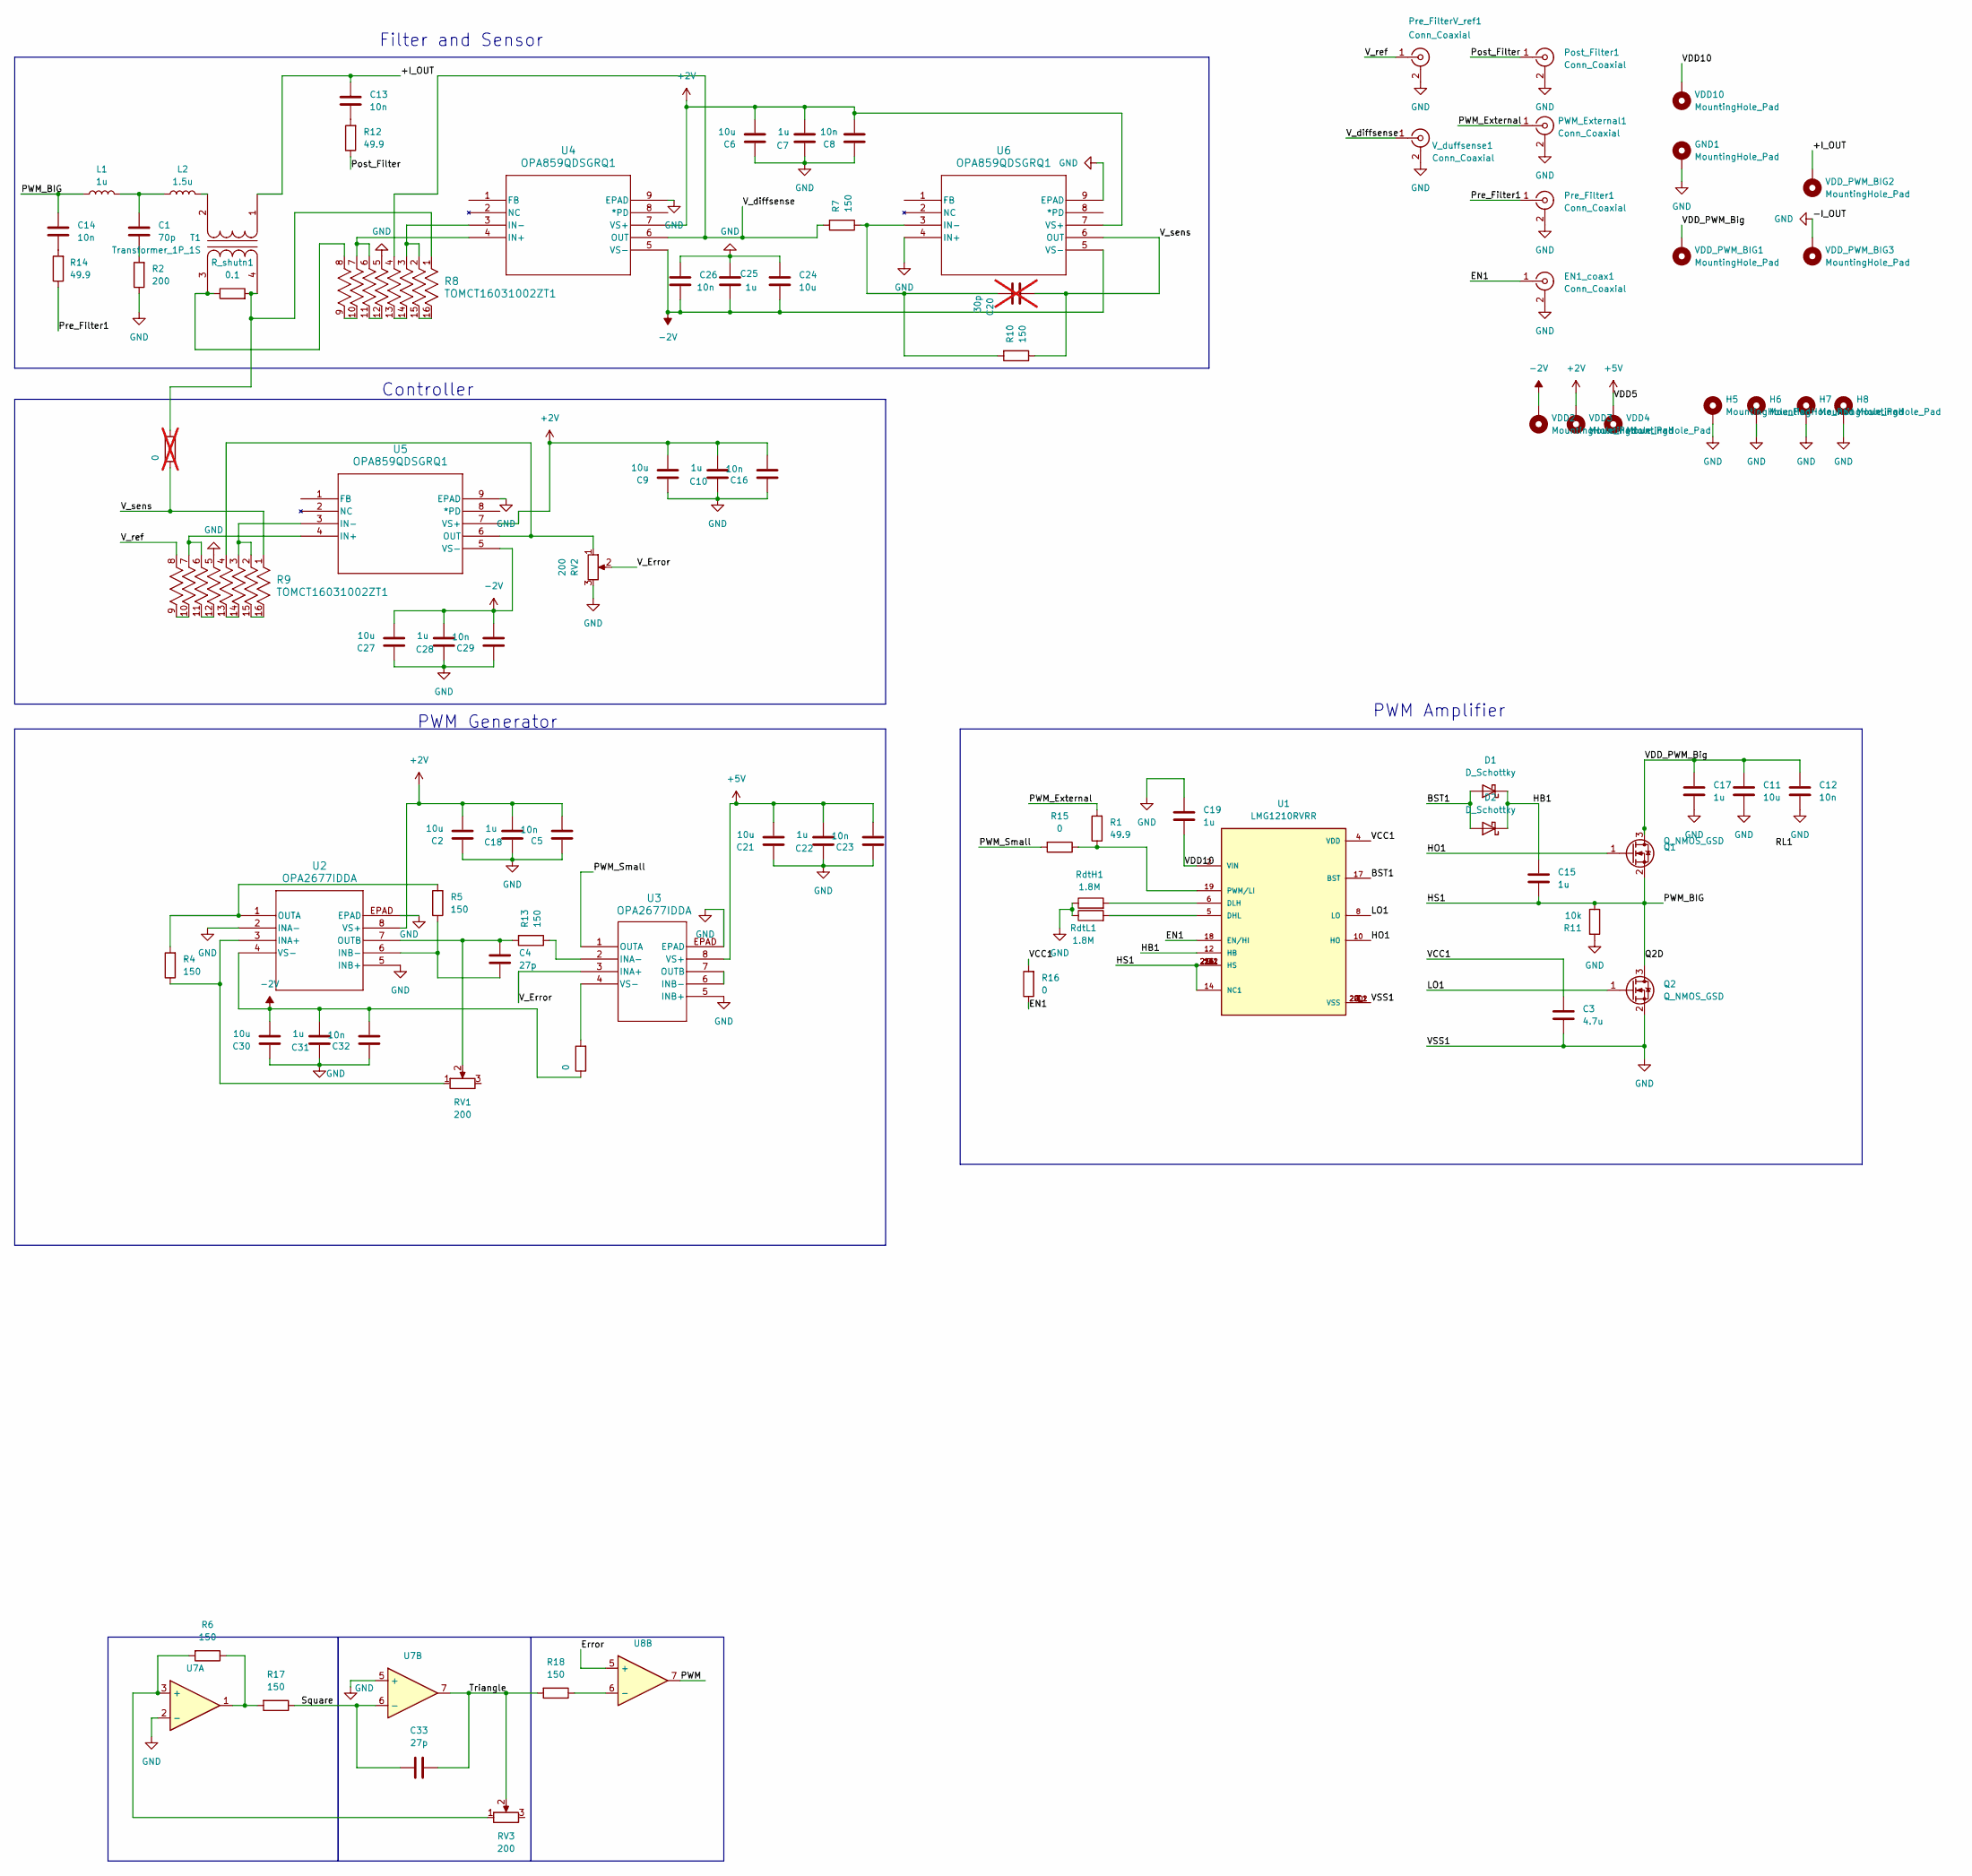
[picture p36: schematic V1.kicad_sch]

Parts:
C1: 70p; R_1206_3216Metric
C2, C21, C30: 10u; C_0402_1005Metric
C3: 4.7u; C_0603_1608Metric
C4, C33: 27p; C_0402_1005Metric
C5, C8, C13, C14, C16, C23, C26, C29, C32: 10n; C_0402_1005Metric
C6, C9, C24, C27: 10u; C_0603_1608Metric
C7, C10, C15, C18, C19, C22, C25, C28, C31: 1u; C_0402_1005Metric
C11: 10u; C_2220_5750Metric
C12: 10n; C_0805_2012Metric
C17: 1u; C_0805_2012Metric
C20: 30p; C_0402_1005Metric; not fitted
D1, D2: D_Schottky; SOT-323_SC-70
EN1_coax1: Conn_Coaxial; U.FL_Molex_MCRF_73412-0110_Vertical
GND1: MountingHole_Pad; MountingHole_2.5mm_Pad_TopBottom
H5, H6, H7, H8: MountingHole_Pad; MountingHole_4.3mm_M4_DIN965_Pad_TopBottom
L1: 1u; INductor_744060421
L2: 1.5u; INductor_744060421
PWM_External1: Conn_Coaxial; U.FL_Molex_MCRF_73412-0110_Vertical
Post_Filter1: Conn_Coaxial; U.FL_Molex_MCRF_73412-0110_Vertical
Pre_Filter1: Conn_Coaxial; U.FL_Molex_MCRF_73412-0110_Vertical
Pre_FilterV_ref1: Conn_Coaxial; U.FL_Molex_MCRF_73412-0110_Vertical
Q1, Q2: Q_NMOS_GSD; EPC8009
R1, R12, R14: 49.9; R_0402_1005Metric
R2: 200; R_1206_3216Metric
R3, R15, R16: 0; C_0805_2012Metric
R4, R5, R7, R10, R13: 150; R_0402_1005Metric
R6, R17, R18: 150
R8, R9: TOMCT16031002ZT1; NOMCT16031
R11: 10k; R_0402_1005Metric
R19: 0; C_0805_2012Metric; not fitted
RV1, RV2, RV3: 200; POT_ 3214W-1-201E
R_shutn1: 0.1; R_1020_2550Metric_Pad1.33x5.20mm_HandSolder
RdtH1: 1.8M; R_0402_1005Metric
RdtL1: 1.8M; R_0402_1005Metric
T1: Transformer_1P_1S; MyTransformer
U1: LMG1210RVRR; IC_LMG1210RVRR; PARTREV D
U2, U3: OPA2677IDDA; DDA8_3X2P49
U4, U5, U6: OPA859QDSGRQ1
U7: OPAMP
U8: Compariotr
VDD2, VDD3, VDD4, VDD10: MountingHole_Pad; TestPoint_THTPad_D2.5mm_Drill1.2mm
VDD_PWM_BIG1, VDD_PWM_BIG2, VDD_PWM_BIG3: MountingHole_Pad; MountingHole_2.5mm_Pad_TopBottom
V_duffsense1: Conn_Coaxial; U.FL_Molex_MCRF_73412-0110_Vertical

Connections:
+2V: C2.2, C5.2, C6.2, C7.2, C8.2, C9.2, C10.2, C16.2, C18.2, U2.8 (VS+), U4.7 (VS+), U5.7 (VS+), U6.7 (VS+), VDD3.1
+5V: C21.2, C22.2, C23.2, U3.8 (VS+), VDD4.1
-2V: C24.2, C25.2, C26.2, C27.2, C28.2, C29.2, C30.2, C31.2, C32.2, R3.1, U2.4 (VS-), U4.5 (VS-), U5.5 (VS-), U6.5 (VS-), VDD2.1
/+I_OUT: C13.2, T1.1 (AA), VDD_PWM_BIG2.1
/BST1: D1.1 (A), D2.1 (A), U1.17 (BST)
/EN1: EN1_coax1.1 (In), R16.1, U1.18 (EN/HI)
/HB1: C15.1, D1.3 (K), D2.3 (K), U1.12 (HB)
/HO1: Q1.1 (G), U1.10 (HO)
/HS1: C14.2, C15.2, L1.1, Q1.2 (S), Q2.3 (D), R11.1, U1.9 (HS), U1.13 (HS), U1.14 (NC1), U1.16 (HS), U1.21 (HS), U1.21_1 (HS), U1.21_2 (HS)
/LO1: Q2.1 (G), U1.8 (LO)
/PWM_External: PWM_External1.1 (In), R1.2
/PWM_Small: R15.2, U3.1 (OUTA)
/Post_Filter: Post_Filter1.1 (In), R12.1
/Pre_Filter1: Pre_Filter1.1 (In), R14.1
/VCC1: C3.1, R16.2, U1.4 (VDD)
/VDD10: C19.2, U1.2 (VIN), VDD10.1
/VDD_PWM_Big: C11.1, C12.1, C17.1, Q1.3 (D), VDD_PWM_BIG1.1
/V_Error: RV2.2, U3.3 (INA+)
/V_diffsense: R7.2, R8.4, U4.6 (OUT), V_duffsense1.1 (In)
/V_ref: Pre_FilterV_ref1.1 (In), R9.8
/V_sens: C20.1, R9.1, R10.1, R19.1, U6.6 (OUT)
GND: C2.1, C3.2, C5.1, C6.1, C7.1, C8.1, C9.1, C10.1, C11.2, C12.2, C16.1, C17.2, C18.1, C19.1, C21.1, C22.1, C23.1, C24.1, C25.1, C26.1, C27.1, C28.1, C29.1, C30.1, C31.1, C32.1, EN1_coax1.2 (Ext), GND1.1, H5.1, H6.1, H7.1, H8.1, PWM_External1.2 (Ext), Post_Filter1.2 (Ext), Pre_Filter1.2 (Ext), Pre_FilterV_ref1.2 (Ext), Q2.2 (S), R2.1, R8.5, R9.5, R11.2, RV2.3, RdtH1.1, RdtL1.1, U1.3 (VSS), U1.7 (VSS), U1.20 (VSS), U1.20_1 (VSS), U1.20_2 (VSS), U2.2 (INA-), U2.5 (INB+), U2.EPAD, U3.5 (INB+), U3.EPAD, U4.9 (EPAD), U5.9 (EPAD), U6.4 (IN+), U6.9 (EPAD), U7.2 (-), U7.5 (+), VDD_PWM_BIG3.1, V_duffsense1.2 (Ext)
unnamed: C1.1, L1.2, L2.1
unnamed: C1.2, R2.2
unnamed: C13.1, R12.2
unnamed: C14.1, R14.2
unnamed: C33.1, R17.1, U7.6 (-)
unnamed: C33.2, R18.2, RV3.2, U7.7
unnamed: R6.2, RV3.1, U7.3 (+)
unnamed: R8.9, R8.10
unnamed: R8.11, R8.12
unnamed: R8.13, R8.14
unnamed: R8.15, R8.16
unnamed: R9.9, R9.10
unnamed: R9.11, R9.12
unnamed: R9.13, R9.14
unnamed: R9.15, R9.16
unnamed: R6.1, R17.2, U7.1
unnamed: R18.1, U8.6 (-)
unnamed: L2.2, T1.2 (AB)
unnamed: R8.8, R_shutn1.1, T1.3 (SA)
unnamed: R8.1, R19.2, R_shutn1.2, T1.4 (SB)
unnamed: RdtL1.2, U1.5 (DHL)
unnamed: RdtH1.2, U1.6 (DLH)
unnamed: R1.1, R15.1, U1.19 (PWM/LI)
unnamed: R4.1, RV1.1, U2.3 (INA+)
unnamed: C4.1, R5.1, U2.6 (INB-)
unnamed: R4.2, R5.2, U2.1 (OUTA)
unnamed: C4.2, R13.2, RV1.2, U2.7 (OUTB)
unnamed: R13.1, U3.2 (INA-)
unnamed: U3.6 (INB-), U3.7 (OUTB)
unnamed: R3.2, U3.4 (VS-)
unnamed: R8.6, R8.7, U4.4 (IN+)
unnamed: R8.2, R8.3, U4.3 (IN-)
unnamed: R9.6, R9.7, U5.4 (IN+)
unnamed: R9.2, R9.3, U5.3 (IN-)
unnamed: R9.4, RV2.1, U5.6 (OUT)
unnamed: C20.2, R7.1, R10.2, U6.3 (IN-)

Notes on the sheet:
Controller
Filter and Sensor
PWM Generator
PWM Amplifier

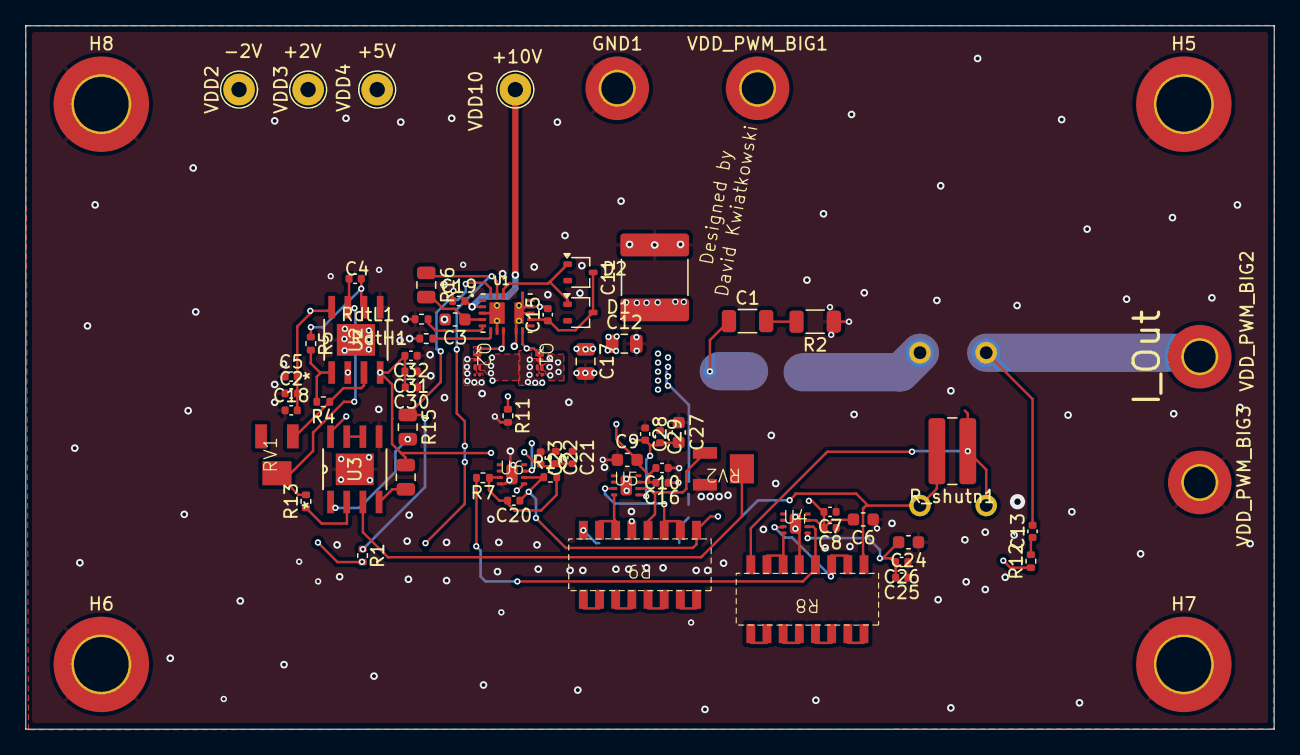
[picture p37: board V1.kicad_pcb from above]

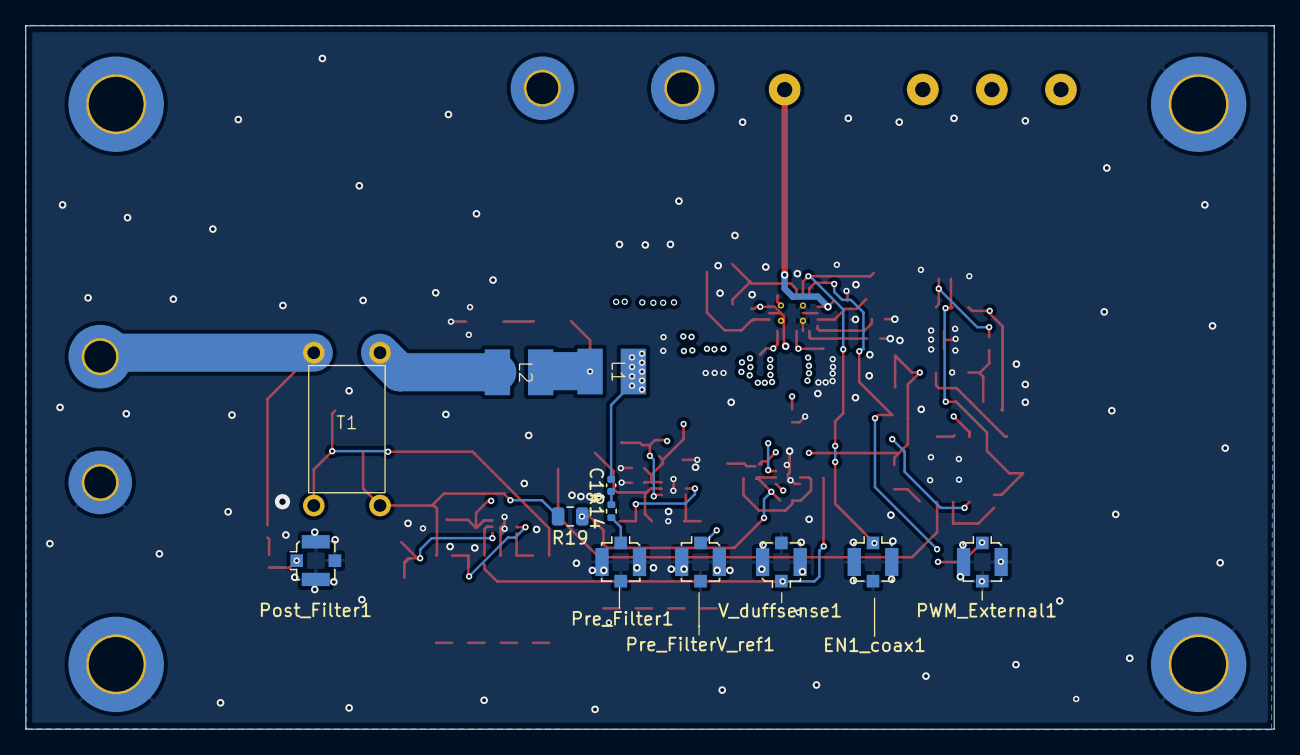
[picture p38: board V1.kicad_pcb from below]

Board: 4 copper layers, 98.0 x 55.2 mm, 84 parts (12 on the bottom side), 53 nets.
