Daavsan/Exjobb/Davids KiCad/MosTest_RfFet/MosTest_RfFet.kicad_pcb

## KiCad design Davids KiCad/MosTest_RfFet/MosTest_RfFet.kicad_pcb (2024-10-29)

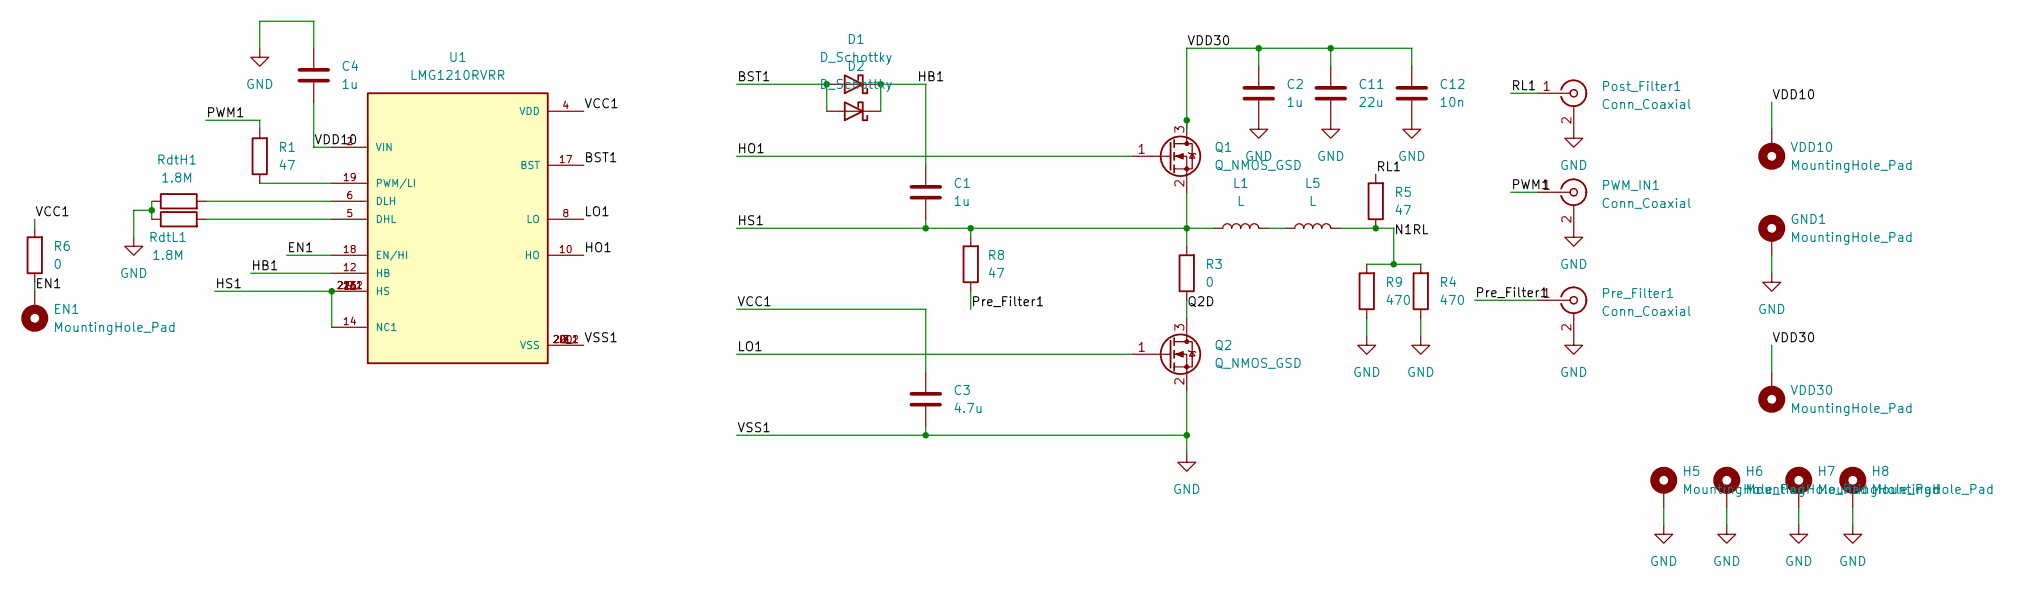
[picture p39: schematic MosTest_RfFet.kicad_sch]

Parts:
C1, C4: 1u; C_0402_1005Metric
C2: 1u; C_0805_2012Metric
C3: 4.7u; C_0402_1005Metric
C11: 22u; C_2220_5750Metric
C12: 10n; C_0805_2012Metric
D1, D2: D_Schottky; SOT-323_SC-70
EN1: MountingHole_Pad; TestPoint_THTPad_D2.5mm_Drill1.2mm
GND1: MountingHole_Pad; MountingHole_2.5mm_Pad_TopBottom
H5, H6, H7, H8: MountingHole_Pad; MountingHole_4.3mm_M4_DIN965_Pad_TopBottom
L1, L5: L; L_Vishay_IHLP-1212
PWM_IN1: Conn_Coaxial; U.FL_Molex_MCRF_73412-0110_Vertical
Post_Filter1: Conn_Coaxial; U.FL_Molex_MCRF_73412-0110_Vertical
Pre_Filter1: Conn_Coaxial; U.FL_Molex_MCRF_73412-0110_Vertical
Q1, Q2: Q_NMOS_GSD; TO-220-3_Vertical
R1, R5, R8: 47; R_0402_1005Metric
R3, R6: 0; R_0805_2012Metric
R4, R9: 470; RWS5
RdtH1: 1.8M; R_0402_1005Metric
RdtL1: 1.8M; R_0402_1005Metric
U1: LMG1210RVRR; IC_LMG1210RVRR; PARTREV D
VDD10: MountingHole_Pad; TestPoint_THTPad_D2.5mm_Drill1.2mm
VDD30: MountingHole_Pad; MountingHole_2.5mm_Pad_TopBottom

Connections:
/BST1: D1.3 (A), D2.3 (A), U1.17 (BST)
/EN1: EN1.1, R6.1, U1.18 (EN/HI)
/HB1: C1.1, D1.1 (K), D2.1 (K), U1.12 (HB)
/HO1: Q1.1 (G), U1.10 (HO)
/HS1: C1.2, L1.1, Q1.2 (S), R3.2, R8.2, U1.9 (HS), U1.13 (HS), U1.14 (NC1), U1.16 (HS), U1.21 (HS), U1.21_1 (HS), U1.21_2 (HS)
/LO1: Q2.1 (G), U1.8 (LO)
/N1RL: L5.2, R4.2, R5.1, R9.2
/PWM1: PWM_IN1.1 (In), R1.2
/Pre_Filter1: Pre_Filter1.1 (In), R8.1
/Q2D: Q2.3 (D), R3.1
/RL1: Post_Filter1.1 (In), R5.2
/VCC1: C3.1, R6.2, U1.4 (VDD)
/VDD10: C4.2, U1.2 (VIN), VDD10.1
/VDD30: C2.1, C11.1, C12.1, Q1.3 (D), VDD30.1
GND: C2.2, C3.2, C4.1, C11.2, C12.2, GND1.1, H5.1, H6.1, H7.1, H8.1, PWM_IN1.2 (Ext), Post_Filter1.2 (Ext), Pre_Filter1.2 (Ext), Q2.2 (S), R4.1, R9.1, RdtH1.1, RdtL1.1, U1.3 (VSS), U1.7 (VSS), U1.20 (VSS), U1.20_1 (VSS), U1.20_2 (VSS)
unnamed: L1.2, L5.1
unnamed: RdtL1.2, U1.5 (DHL)
unnamed: RdtH1.2, U1.6 (DLH)
unnamed: R1.1, U1.19 (PWM/LI)

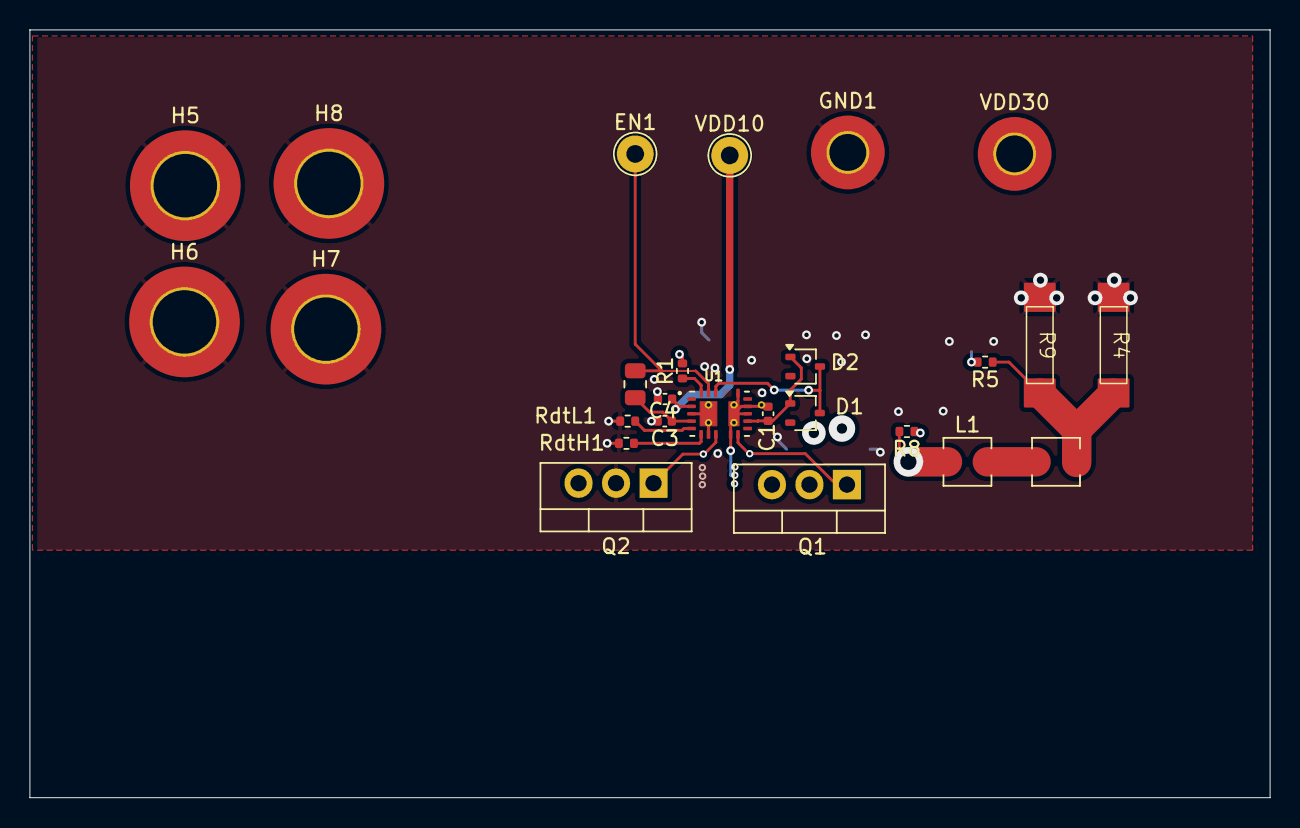
[picture p40: board MosTest_RfFet.kicad_pcb from above]

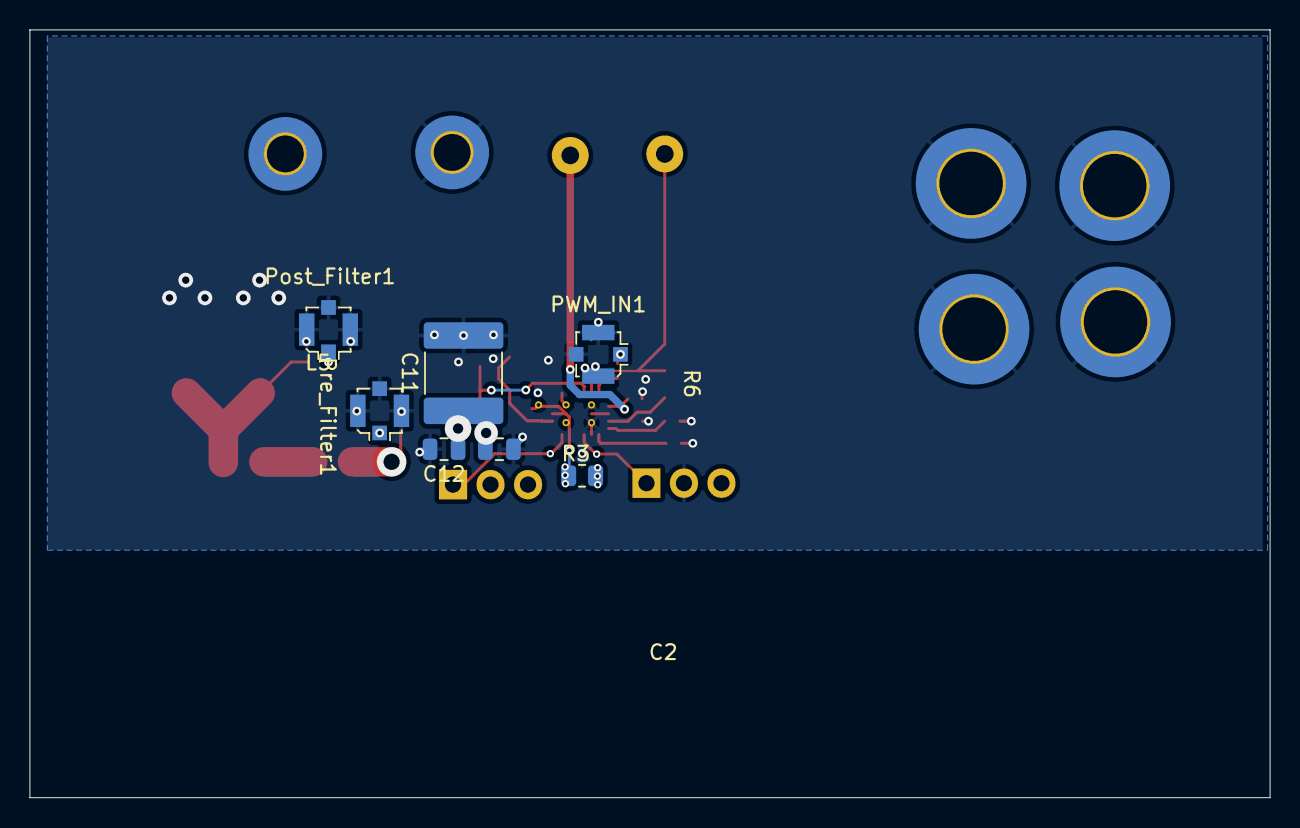
[picture p41: board MosTest_RfFet.kicad_pcb from below]

Board: 4 copper layers, 84.0 x 52.0 mm, 33 parts (7 on the bottom side), 19 nets.
