Daavsan/Exjobb/(commit log)

2024-10-29 add laptop stuff
    [100nsGATES.Wfm.csv, 100nsGATES.csv, 100nsHighGateSourcecsv.Wfm.csv, 100nsHighGateSourcecsv.csv, 200nsNoisydioseDropVS-1xdiode.csv, 200nsNoisydioseDropVS-1xdiode.wfm.csv, 200nsNoisydioseDropVS-2xdiode.csv, 200nsNoisydioseDropVS-2xdiode.wfm.csv]
2024-10-29 added more tests
    [1xbin.Wfm.csv, 1xbin.csv, 50nsGates3nstdt.Wfm.csv, 50nsGates3nstdt.csv, NOFetGate.Wfm.csv, NOFetGate.csv, test.Wfm.csv, test.csv]
2024-11-01 matlap osscilisope plot function
    [MosTest_cadence.dsn]
2024-11-01 switch loss matlab script bugfix
2024-11-05 plotter and more files
    [GanFetMinPW.Wfm.csv, GanFetMinPW.csv, MinINPulse.Wfm.csv, MinINPulse.csv]
2024-11-05 more mesurments and added plotter rescale function
    [DiffGanVoHighVgs.Wfm.csv, DiffGanVoHighVgs.csv, DiffGanVoLowVgs.Wfm.csv, DiffGanVoLowVgs.csv, DiffHighVgs.Wfm.csv, DiffHighVgs.csv, ganGatesPreFilter.Wfm.csv, ganGatesPreFilter.csv]
2024-11-14 filters wokring :]
    [BREAKOUT2.OLB, Filter Test.opj, Filter.dsn, Filter.opj, PWM Generator 2.dsn, PWM Generator 2.opj, PWM Generator.dsn, PWM Generator.opj]
2024-11-15 kickad start and simulation changes
    [Current Sense.kicad_sch, Driver.kicad_sch, Filter.kicad_sch, PWM Generator.dsn, PWM_Generator.kicad_sch, V1.kicad_pcb, V1.kicad_sch]
2024-11-17 kicad scematic
    [Current Sense.kicad_sch, Driver.kicad_sch, Filter.dsn, PWM Generator.dsn, PWM_Generator.kicad_sch, V1.kicad_sch]
2024-11-21 Worked on V1 PCB
    [Filter.dsn, PWM Generator.dsn, SummTest.dsn, SummTest.opj, V1.kicad_pcb, V1.kicad_sch]
2024-11-22 added integrator
    [V1.kicad_pcb, V1.kicad_sch]
2024-11-25 V1 pcb almost done
    [Filter.dsn, V1.kicad_pcb, V1.kicad_sch]
2024-11-25 V1 done
    [V1.kicad_pcb, V1.kicad_sch]
2024-11-25 Fixed GanfetPad clerance
    [Digikey_2024-11-25T085315.csv, V1.kicad_pcb, V1.kicad_sch, Your Basket - RS - 2024-11-25 15_54_34.csv]
2024-11-27 Borgs pcb via addition
    [V1.kicad_pcb]
2024-11-27 Fixed driver missing mask layer
    [MosTest_GanFet.kicad_pcb, V1.kicad_pcb]
2024-12-11 pott pwm gen stuff
    [PWMGen-sqare-prefilt.csv, PWMGen-tri-prefilt.csv, PWMGen-tri-prefit.csv]
2024-12-11 added pwm out plot
    [PWMGen-pwm-prefilt.csv]
2024-12-17 boom and stuff
    [V1.kicad_pcb]
2025-01-10 fixed pwm gen negative supply voltage
    [V1.kicad_pcb, V1.kicad_sch]
2025-01-10 aded alternative path for curent sense signal
    [V1.kicad_pcb, V1.kicad_sch]
2025-01-17 v1 mes
    [vdiff-probe-direct-32v-30mhz50%.csv, vdiff-shuntprobe(noisy)-32v-50%30Mhz.csv, vdiff-vout-fsw30M330ohm32v50%.csv]
2025-01-27 ccdesign matlab
    [Filter Test.opj, SummTest.opj, V1.kicad_sch]
